EmiliamBeke/Mekatronikk-4-MEPA2002/src/robot_gz/models/sim_teddy_bear/materials/textures/back.png

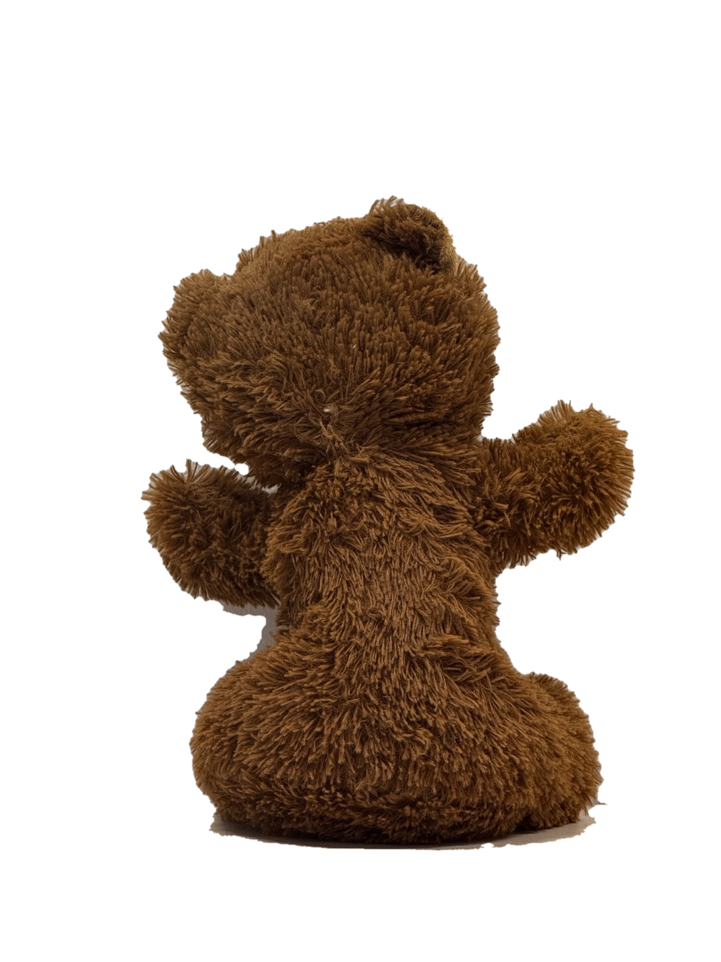
src/robot_gz/models/sim_teddy_bear/materials/textures/back.png
