EmiliamBeke/Mekatronikk-4-MEPA2002/docs/lidar_rviz.md

# LiDAR + YOLO Image i RViz (Pi + PC)

Kort oppskrift for å se LiDAR live i RViz.

Kamera- og YOLO-innstillinger ligger i [config/camera_params.yaml](/home/emiliam/Mekatronikk-4-MEPA2002/config/camera_params.yaml).
`camera_stream` gjelder felles stream til baade teddy-detektor og RViz, mens `teddy_detector` bare gjelder YOLO-parametre.
Hvis fargene ser feil ut, er `camera_stream.awb`, `awb_gains`, `brightness`, `contrast`, `saturation`, `sharpness`, `denoise` og `ev` de foerste feltene aa justere.

## 1) Start robotstack på Pi

```bash
cd ~/Mekatronikk-4-MEPA2002
WITH_NAV2=0 WITH_TEDDY=1 make pi-bringup
```

Dette scriptet:

1. finner PC-IP fra SSH-sesjonen
2. setter `ROS_DOMAIN_ID`, `ROS_AUTOMATIC_DISCOVERY_RANGE` og `ROS_STATIC_PEERS`
3. starter `robot_state_publisher`, LiDAR og teddy-detektor i samme Docker-kjoering
4. sender annotert YOLO-video til PC hvis `teddy_detector.stream_debug_video: true` i [config/camera_params.yaml](/home/emiliam/Mekatronikk-4-MEPA2002/config/camera_params.yaml)

Hvis du bare vil se LiDAR + TF uten teddy:

```bash
WITH_NAV2=0 make pi-bringup
```

## 2) Start RViz-oppsettet på PC

Fra PC-en er standarden naa:

```bash
cd ~/Mekatronikk-4-MEPA2002
make pc-teddy-rviz
```

Dette scriptet:

1. setter ROS discovery mot Pi automatisk
2. starter lokal UDP->ROS bridge for annotert YOLO-bilde
3. aapner RViz med [rviz.rviz](/home/emiliam/Mekatronikk-4-MEPA2002/src/robot_bringup/rviz/rviz.rviz)

Hvis hostnavnet ikke virker, bruk Pi-IP direkte:

```bash
make pc-teddy-rviz PI_HOST=192.168.10.55
```

## 3) Verifiser fra PC

```bash
ros2 topic list | grep lidar
ros2 topic hz /lidar
ros2 topic echo --once /tf_static
ros2 topic list | grep teddy_detector
```

## 4) Start RViz på PC

Denne konfigen er laget for situasjonen deres akkurat naa:

1. `Fixed Frame = odom`
2. `LaserScan` bruker `/lidar` med `Reliability = Best Effort`
3. `RobotModel` bruker `/robot_description`
4. `Image`-display viser `/camera`
5. `TF`, odometri, footprint og planer kan slas av/paa i samme konfig

Hvis du vil sette opp manuelt i stedet:

1. `Global Options -> Fixed Frame = odom`
2. `Add -> LaserScan`
3. `Topic = /lidar`
4. Under `Topic`:
   `Reliability Policy = Best Effort`
5. `Add -> RobotModel` og bruk `/robot_description`
6. `Add -> Image` og bruk `/camera`
7. Bruk `odom` som fixed frame naar odometri er oppe

## 5) Valgfritt: raa kamera til RViz over UDP

Pi:

```bash
WITH_NAV2=0 WITH_TEDDY=1 WITH_CAMERA_RVIZ=1 make pi-bringup
```

Dette beholder teddy-detektor paa Pi, men sender i tillegg H264 over UDP til PC-en paa port `5601`.

PC:

```bash
make pc-camera-rviz PI_HOST=gruppe5pi5
```

Det starter en lokal ROS-node paa PC-en som dekoder UDP-stroemmen og publiserer `/camera`.
Dette er valgfritt; standarden deres naa er annotert YOLO-bilde via `make pc-teddy-rviz`.

## Feilsøking (kort)

- `empty topicname`: `LaserScan`-display har tom `Topic`. Sett `/lidar`.
- Ingen topic på PC: sjekk at `make pi-bringup` fortsatt kjører på Pi, og prøv `make pc-teddy-rviz PI_HOST=<pi-host-eller-ip>` på nytt.
- Hvis `RobotModel` ser rar ut, men `tf2_echo chassis base_laser` ser riktig ut: stol heller på LiDAR + TF foreløpig. Dere publiserer ikke `/joint_states` ennå.
- Hvis YOLO-bilde ikke vises på PC: sjekk at PC-workspace er bygget, at `make pc-teddy-rviz` fortsatt kjører, og at UDP-port `5602` ikke blokkeres.
- Hvis råkamera ikke vises på PC: sjekk at `gst-launch-1.0` finnes på PC, og at UDP-port `5601` ikke blokkeres.
- Hvis `/dev/ttyAMA0` ikke virker: test `port_name:=/dev/serial0`.
- Hvis auto-detection på Pi bommer: bruk `PC_HOST=<pc-ip> make pi-bringup`.
