EmiliamBeke/Mekatronikk-4-MEPA2002/src/robot_description/meshes/RFWheelColision.stl

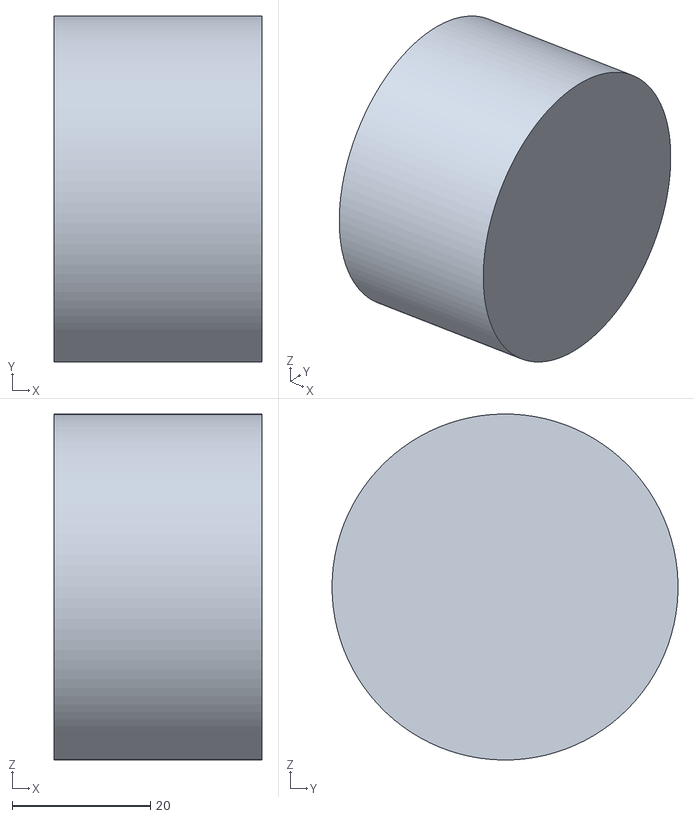
[picture p5: CAD file, 2026-05-09]
src/robot_description/meshes/RFWheelColision.stl
30.0 x 50.0 x 50.0
