EmiliamBeke/Mekatronikk-4-MEPA2002/src/robot_gz/models/tracked_robot/meshes/BLLegs.stl

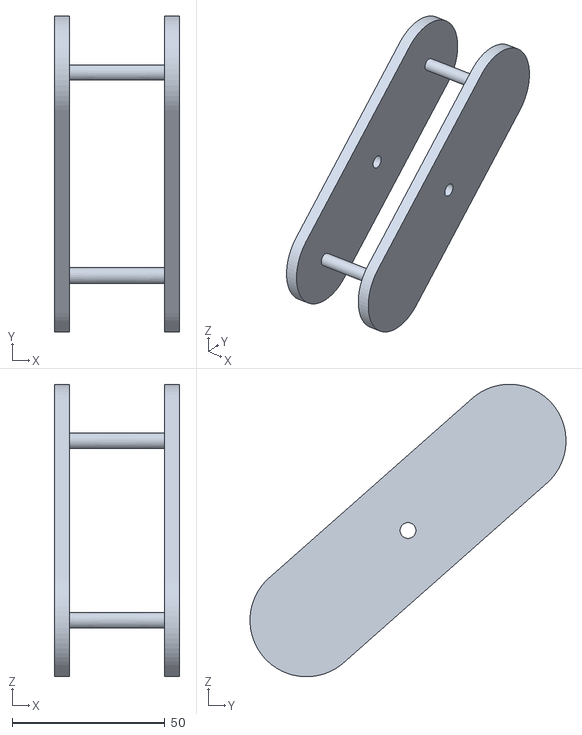
[picture p6: CAD file, 2026-05-09]
src/robot_gz/models/tracked_robot/meshes/BLLegs.stl
41.0 x 103.5 x 95.7
