EmiliamBeke/Mekatronikk-4-MEPA2002/src/robot_description/meshes/LDriveWheel.stl

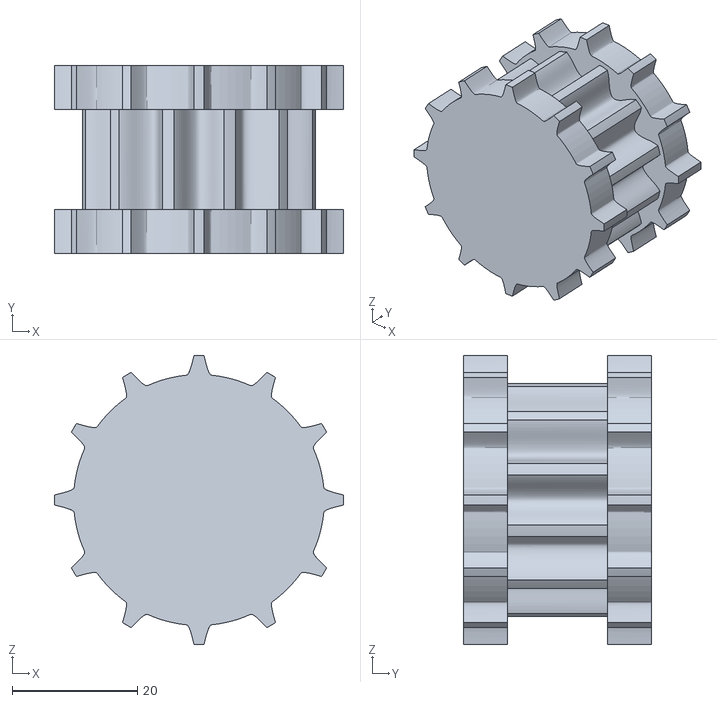
[picture p7: CAD file, 2026-05-09]
src/robot_description/meshes/LDriveWheel.stl
46.1 x 30.0 x 46.1
