EmiliamBeke/Mekatronikk-4-MEPA2002/src/robot_gz/models/tracked_robot/meshes/Xstepper.stl

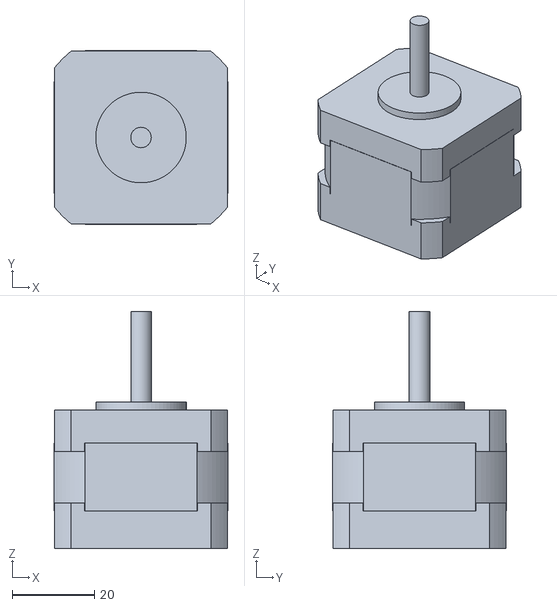
[picture p8: CAD file, 2026-05-09]
src/robot_gz/models/tracked_robot/meshes/Xstepper.stl
42.2 x 42.2 x 57.6
