EmiliamBeke/Mekatronikk-4-MEPA2002/src/robot_description/meshes/rps-kamera-v2-2.stl

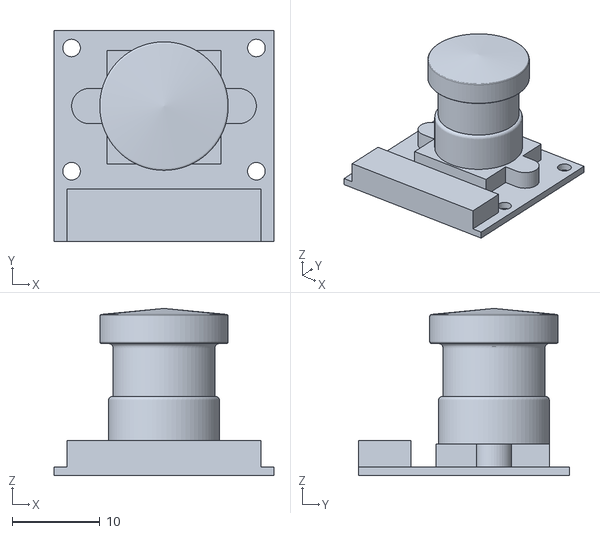
[picture p9: CAD file, 2026-05-09]
src/robot_description/meshes/rps-kamera-v2-2.stl
25.0 x 24.0 x 19.0
