EmiliamBeke/Mekatronikk-4-MEPA2002/src/robot_gz/models/tracked_robot/meshes/Gripper.stl

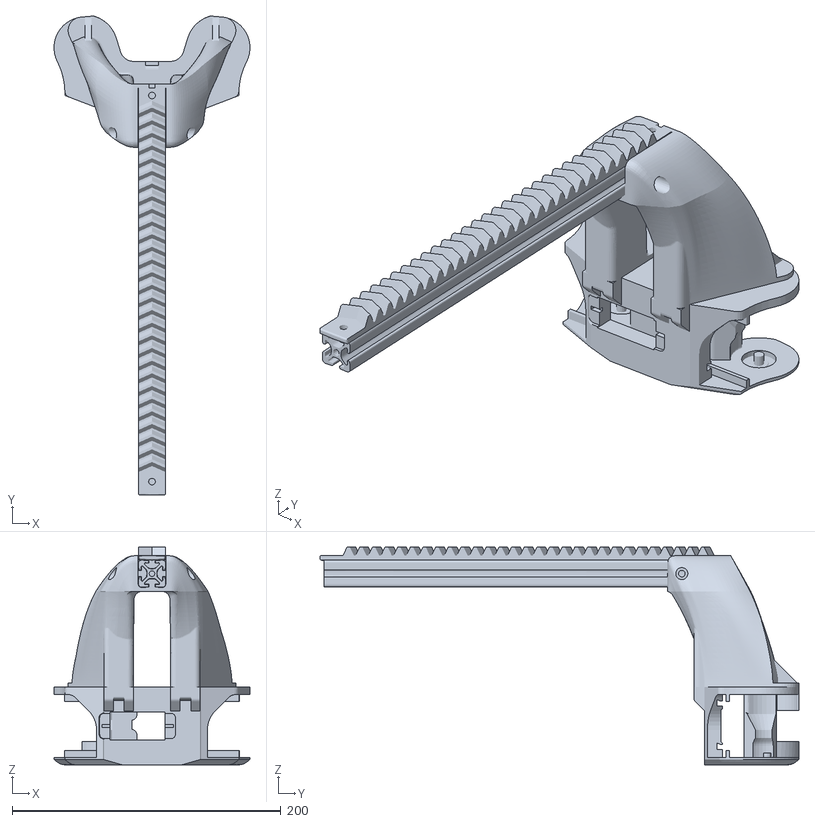
[picture p10: CAD file, 2026-05-09]
src/robot_gz/models/tracked_robot/meshes/Gripper.stl
146.0 x 356.8 x 162.3
