EmiliamBeke/Mekatronikk-4-MEPA2002/src/robot_description/meshes/Mega-wsheeld-v5-1.stl

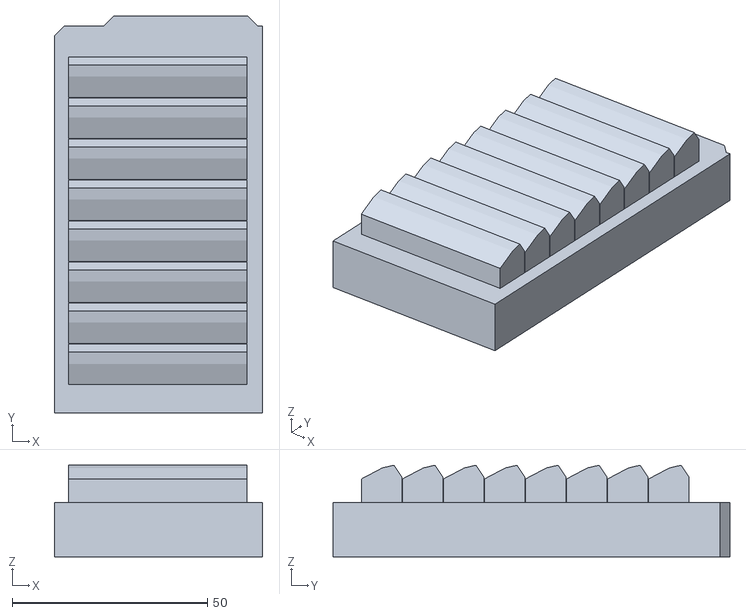
[picture p11: CAD file, 2026-05-09]
src/robot_description/meshes/Mega-wsheeld-v5-1.stl
53.3 x 101.6 x 23.4
