EmiliamBeke/Mekatronikk-4-MEPA2002/src/robot_gz/models/tracked_robot/meshes/StøtteStag-1.stl

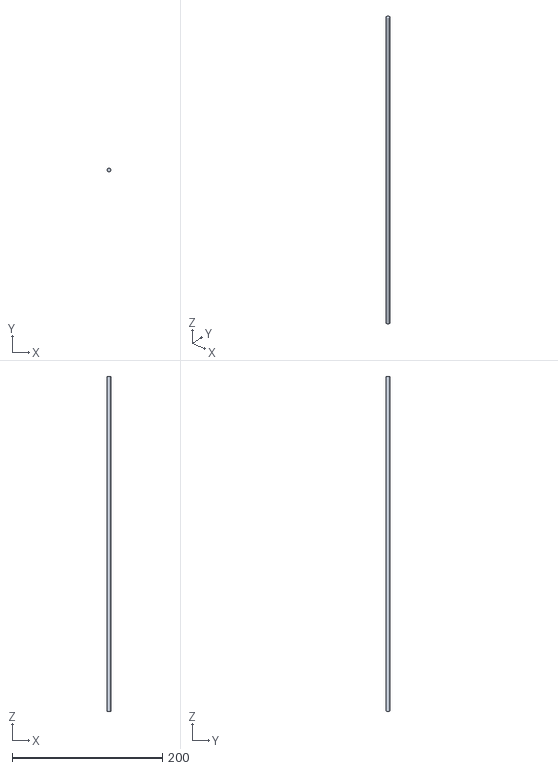
[picture p12: CAD file, 2026-05-09]
src/robot_gz/models/tracked_robot/meshes/StøtteStag-1.stl
5.00 x 4.87 x 445.3
