EmiliamBeke/Mekatronikk-4-MEPA2002/src/robot_description/meshes/M1.stl

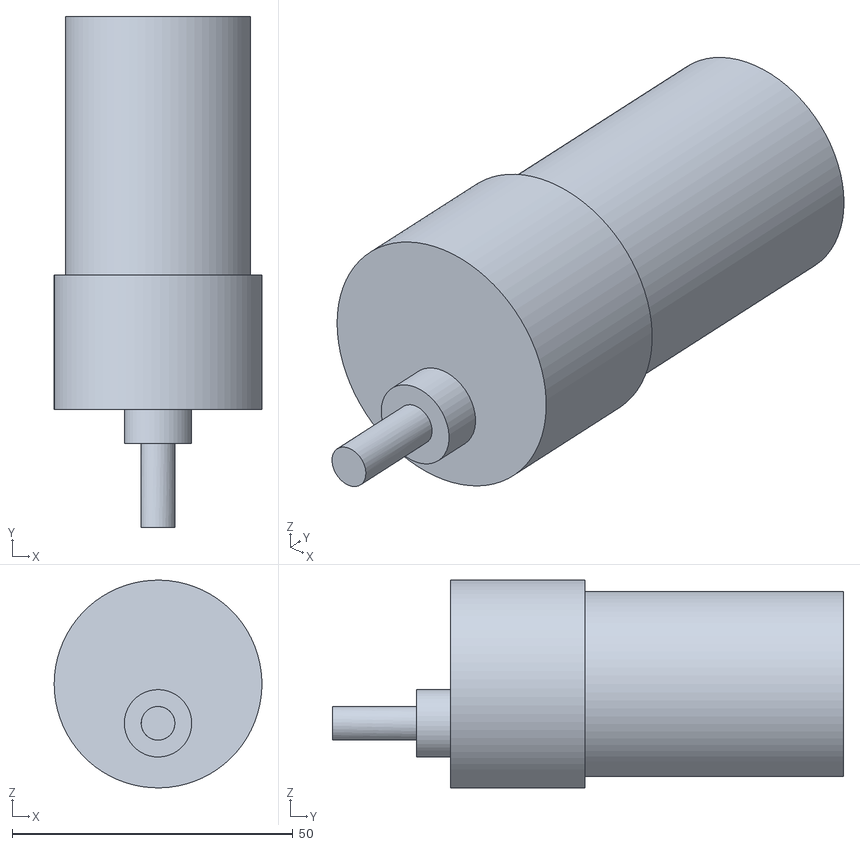
[picture p13: CAD file, 2026-05-09]
src/robot_description/meshes/M1.stl
37.0 x 91.0 x 37.0
