EmiliamBeke/Mekatronikk-4-MEPA2002/src/robot_gz/models/tracked_robot/meshes/Servo-Gear-8L30.00-m2.1651.stl

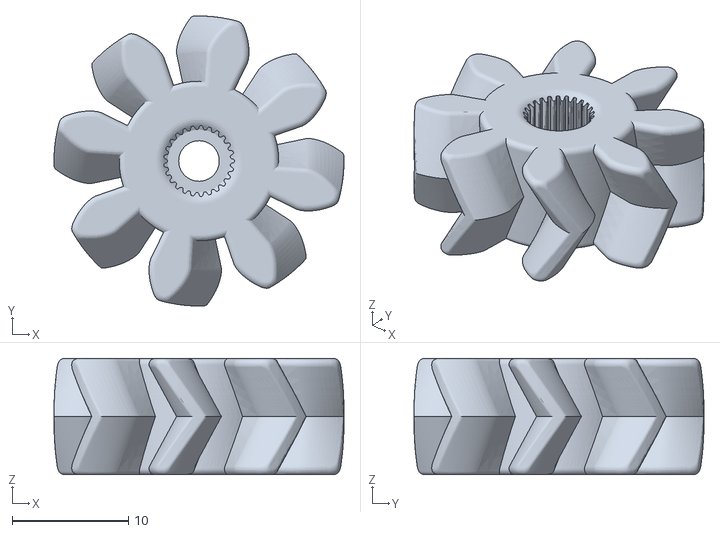
[picture p14: CAD file, 2026-05-09]
src/robot_gz/models/tracked_robot/meshes/Servo-Gear-8L30.00-m2.1651.stl
25.0 x 25.0 x 10.0
