EmiliamBeke/Mekatronikk-4-MEPA2002/src/robot_gz/models/tracked_robot/meshes/LTracks.stl

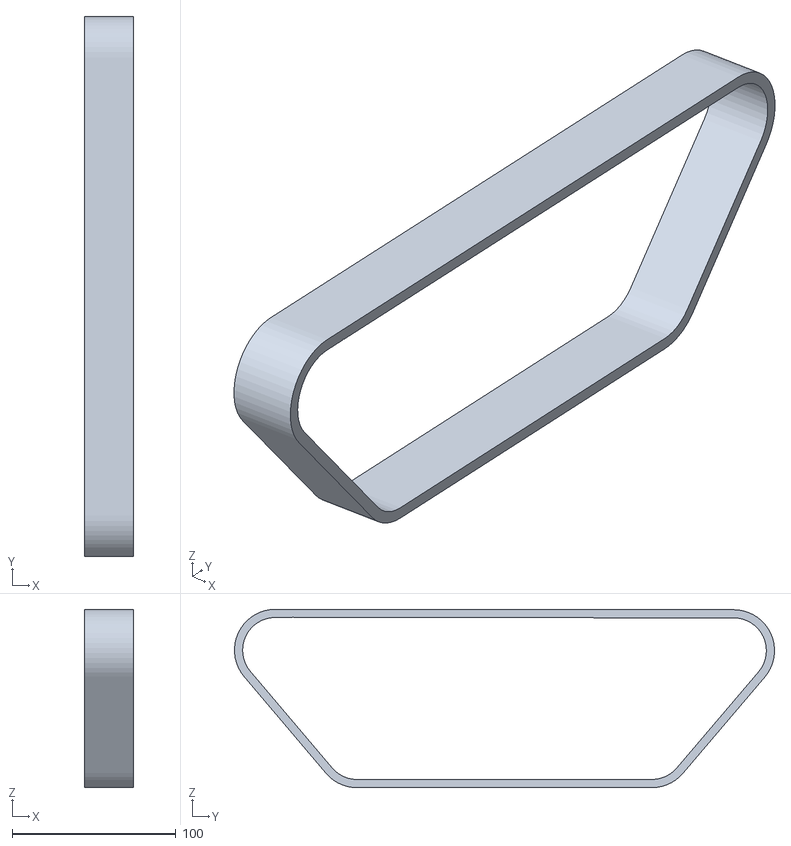
[picture p15: CAD file, 2026-05-09]
src/robot_gz/models/tracked_robot/meshes/LTracks.stl
30.0 x 329.9 x 109.0
