EmiliamBeke/Mekatronikk-4-MEPA2002/src/robot_description/meshes/LFWheel.stl

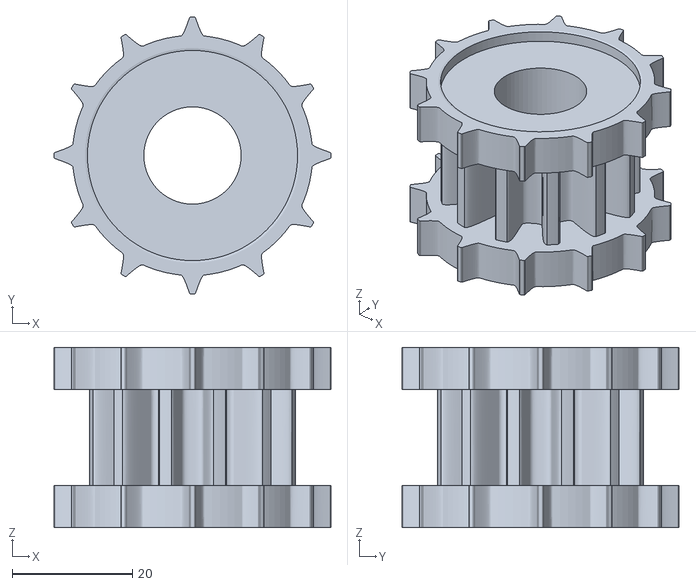
[picture p16: CAD file, 2026-05-09]
src/robot_description/meshes/LFWheel.stl
46.1 x 46.1 x 30.0
