EmiliamBeke/Mekatronikk-4-MEPA2002/src/robot_gz/models/tracked_robot/meshes/LD06_LiDAR-1.stl

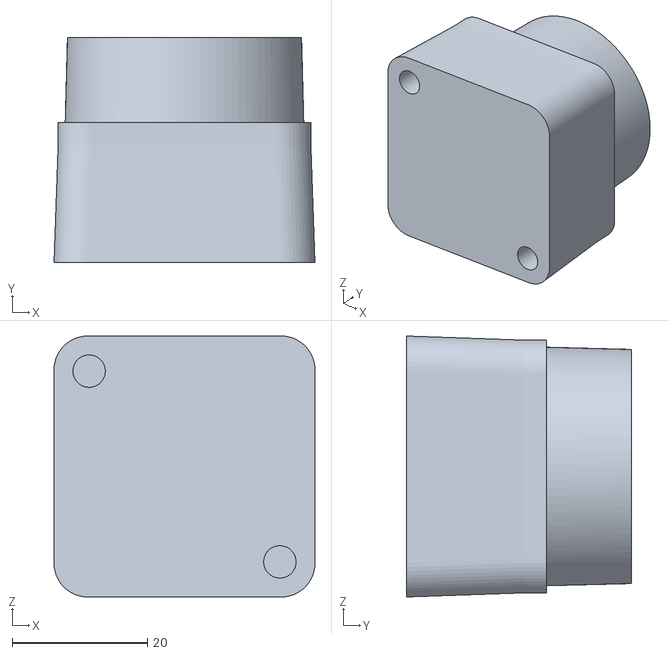
[picture p17: CAD file, 2026-05-09]
src/robot_gz/models/tracked_robot/meshes/LD06_LiDAR-1.stl
38.6 x 33.3 x 38.6
