EmiliamBeke/Mekatronikk-4-MEPA2002/src/robot_description/meshes/LeadNutL.stl

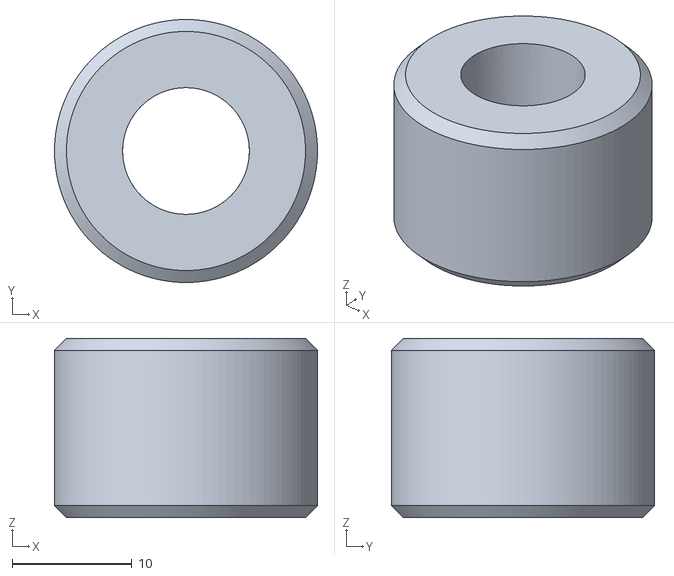
[picture p18: CAD file, 2026-05-09]
src/robot_description/meshes/LeadNutL.stl
22.0 x 22.0 x 15.0
