EmiliamBeke/Mekatronikk-4-MEPA2002/src/robot_gz/models/tracked_robot/meshes/Unyaktig-batteri-mockup-v1-1.stl

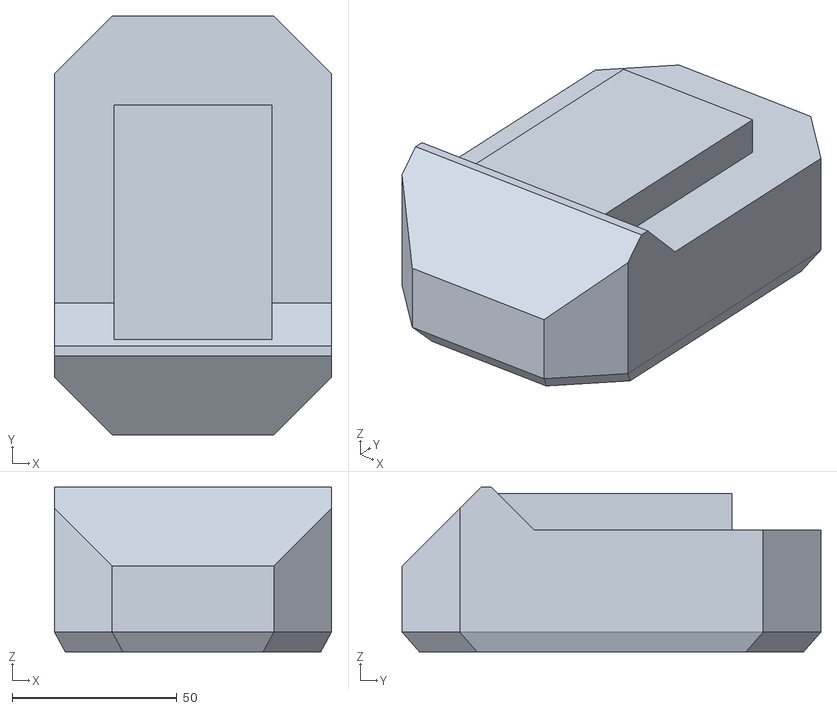
[picture p19: CAD file, 2026-05-09]
src/robot_gz/models/tracked_robot/meshes/Unyaktig-batteri-mockup-v1-1.stl
84.0 x 127.0 x 50.0
