EmiliamBeke/Mekatronikk-4-MEPA2002/src/robot_description/meshes/Chassis.stl

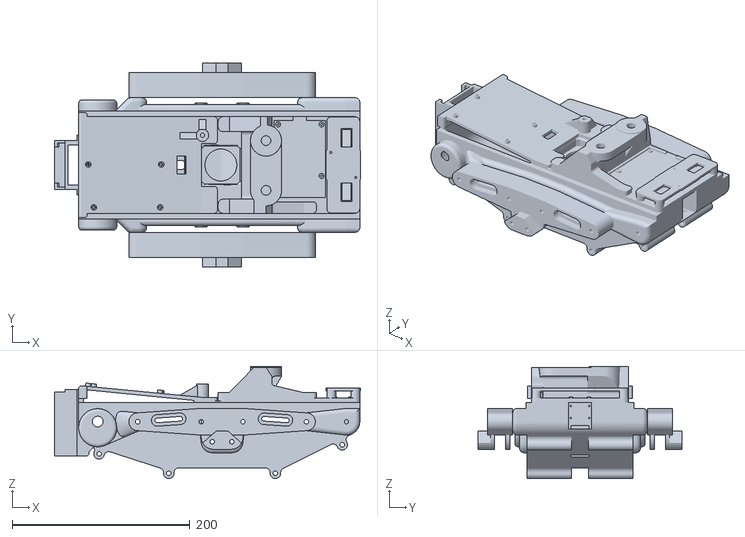
[picture p20: CAD file, 2026-05-09]
src/robot_description/meshes/Chassis.stl
344.4 x 229.6 x 126.2
