EmiliamBeke/Mekatronikk-4-MEPA2002/src/robot_description/meshes/Finger-R16L30.00-m2.1651Mirror.stl

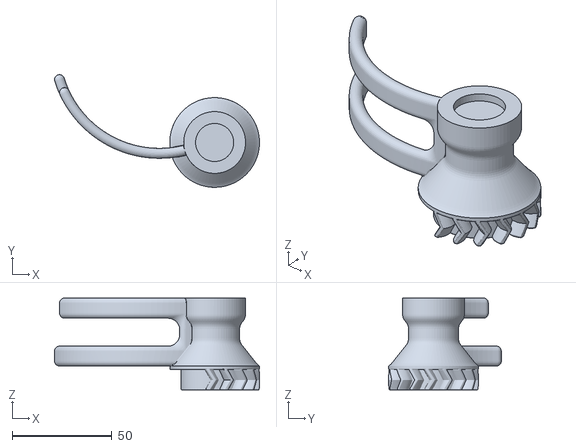
[picture p21: CAD file, 2026-05-09]
src/robot_description/meshes/Finger-R16L30.00-m2.1651Mirror.stl
102.8 x 56.5 x 46.1
