EmiliamBeke/Mekatronikk-4-MEPA2002/src/robot_description/meshes/Gear-9R24.00-m2.741-1-1.stl

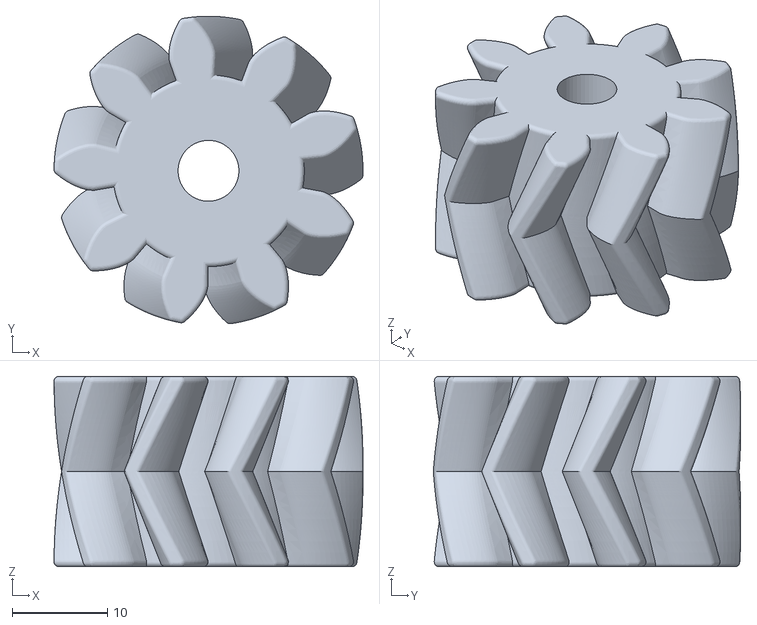
[picture p22: CAD file, 2026-05-09]
src/robot_description/meshes/Gear-9R24.00-m2.741-1-1.stl
32.5 x 32.3 x 20.0
