EmiliamBeke/Mekatronikk-4-MEPA2002/src/robot_gz/models/tracked_robot/meshes/BN0085.stl

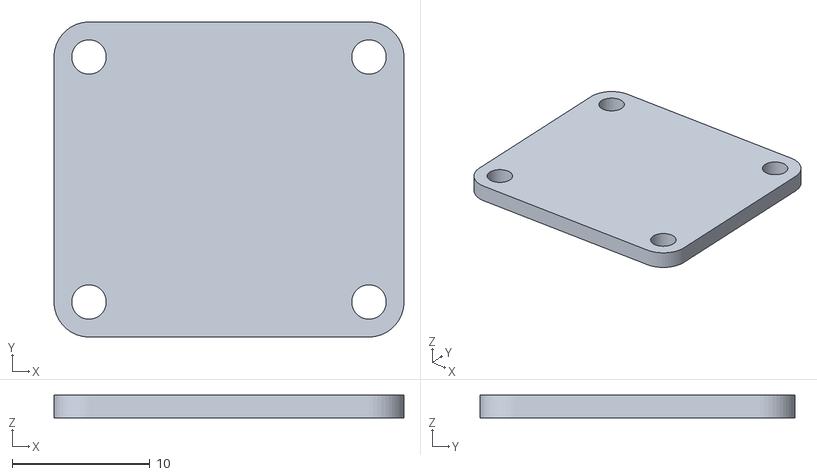
[picture p23: CAD file, 2026-05-09]
src/robot_gz/models/tracked_robot/meshes/BN0085.stl
25.4 x 22.9 x 1.65
