EmiliamBeke/Mekatronikk-4-MEPA2002/src/robot_description/meshes/Top-Rack-200.0mm-R30.00-m2.1651.stl

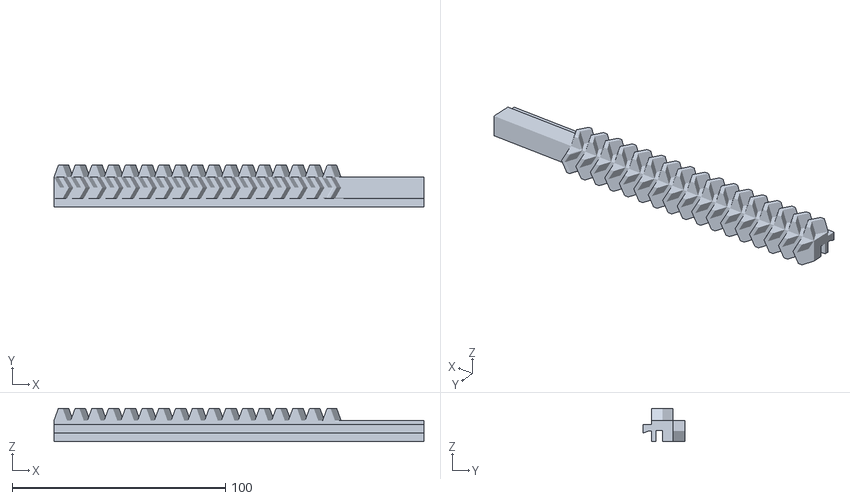
[picture p24: CAD file, 2026-05-09]
src/robot_description/meshes/Top-Rack-200.0mm-R30.00-m2.1651.stl
173.5 x 19.6 x 15.6
