EmiliamBeke/Mekatronikk-4-MEPA2002/src/robot_gz/models/tracked_robot/meshes/PI5.stl

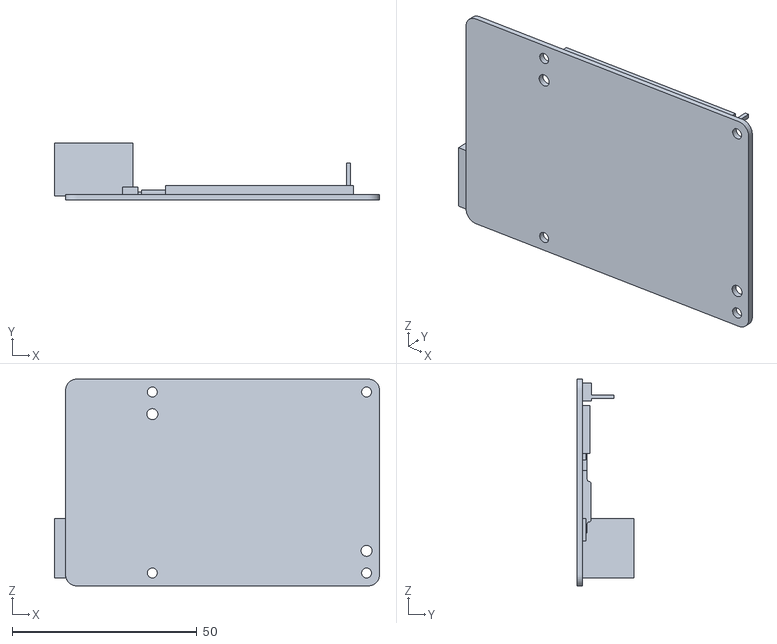
[picture p25: CAD file, 2026-05-09]
src/robot_gz/models/tracked_robot/meshes/PI5.stl
88.0 x 15.3 x 56.0
