EmiliamBeke/Mekatronikk-4-MEPA2002/src/robot_description/meshes/Servo.stl

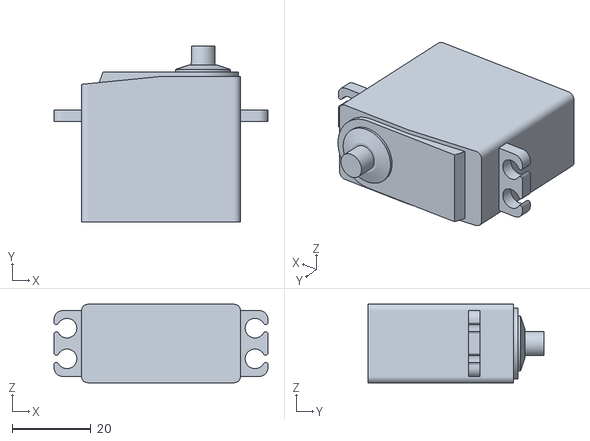
[picture p26: CAD file, 2026-05-09]
src/robot_description/meshes/Servo.stl
54.5 x 44.7 x 20.0
