EmiliamBeke/Mekatronikk-4-MEPA2002/src/robot_description/meshes/ZStepper.stl

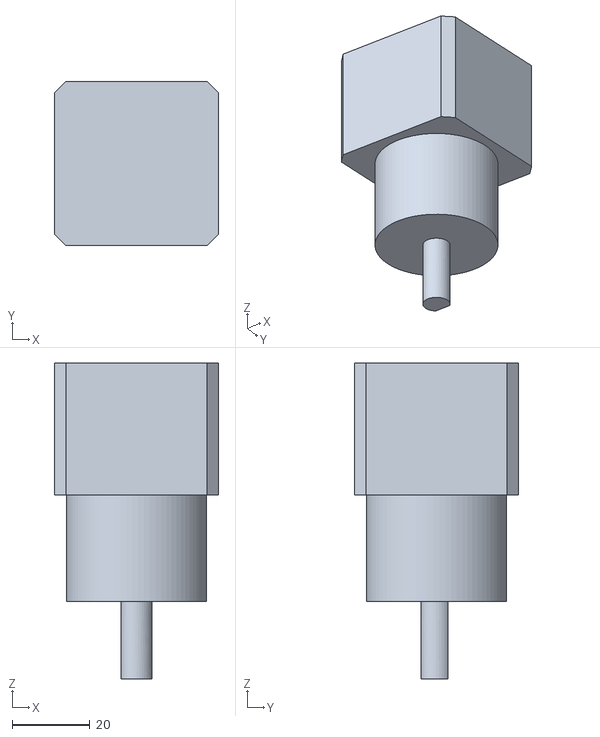
[picture p28: CAD file, 2026-05-09]
src/robot_description/meshes/ZStepper.stl
42.3 x 42.3 x 81.3
