EmiliamBeke/Mekatronikk-4-MEPA2002/(list of files, cad)

Other CAD files:
src/robot_gz/models/tracked_robot/meshes/FRLegs.stl
src/robot_gz/models/tracked_robot/meshes/FLLegs.stl
src/robot_gz/models/tracked_robot/meshes/RTracks.stl
src/robot_description/meshes/RTWheel.stl
src/robot_gz/models/tracked_robot/meshes/RTWheel.stl
src/robot_description/meshes/BRLegs.stl
src/robot_description/meshes/RDriveWheel.stl
src/robot_gz/models/tracked_robot/meshes/RFWheel.stl
src/robot_description/meshes/RBWheel.stl
src/robot_description/meshes/Finger-L-16L30.00-m2.1651.stl
src/robot_gz/models/tracked_robot/meshes/RBWheel.stl
src/robot_gz/models/tracked_robot/meshes/Finger-L-16L30.00-m2.1651.stl
src/robot_description/meshes/FRLegs.stl
src/robot_description/meshes/FLLegs.stl
src/robot_description/meshes/RFWheel.stl
src/robot_gz/models/tracked_robot/meshes/Bottom-Rack-200.0mm-L30.00-m2.1651.stl
src/robot_gz/models/tracked_robot/meshes/M2.stl
src/robot_gz/models/tracked_robot/meshes/RDriveWheel.stl
src/robot_description/meshes/M2.stl
src/robot_gz/models/tracked_robot/meshes/BRLegs.stl
src/robot_description/meshes/RTracks.stl
src/robot_description/meshes/Bottom-Rack-200.0mm-L30.00-m2.1651.stl
src/robot_description/meshes/ABX00102-Dist-sensor.stl
src/robot_description/meshes/LLeadscrew.stl
src/robot_description/meshes/Leadscrew-Rigg.stl
src/robot_description/meshes/RLeadscrew.stl
src/robot_gz/models/tracked_robot/meshes/ABX00102-Dist-sensor.stl
src/robot_gz/models/tracked_robot/meshes/LLeadscrew.stl
src/robot_gz/models/tracked_robot/meshes/Leadscrew-Rigg.stl
src/robot_gz/models/tracked_robot/meshes/RLeadscrew.stl
