EmiliamBeke/Mekatronikk-4-MEPA2002/docs/wiki/build-and-environment.md

# Bygg og Miljø

## Bunnlinje

PC/sim bygges normalt direkte med colcon. Pi/runtime bygges normalt inne i Docker.
Source order betyr noe utenfor Docker.

## Host / PC Build

```bash
cd ~/Mekatronikk-4-MEPA2002
source /opt/ros/jazzy/setup.bash
colcon build --symlink-install
source install/setup.bash
```

Bruk dette for:

- Gazebo simulering.
- RViz.
- PC UDP camera bridge.
- PC ROS keyboard teleop.

## Pi / Docker Build

```bash
cd ~/Mekatronikk-4-MEPA2002
make ws
```

Dette er normal Pi-build for kodeendringer. `make ws` bygger ROS-workspacet i
det Docker-imaget som allerede finnes.

`make build` er **ikke** en vanlig operatørkommando. Ikke bygg Docker-imaget på
nytt bare fordi du har endret Python-kode, launch-filer, YAML-konfig eller
Arduino-sketcher.

Buildx / BuildKit (anbefalt for Pi)
----------------------------------

Pi-en bruker nå `docker buildx` og BuildKit for mer pålitelige builds med
`docker/` som build-context. Buildx-builderen beholder intern layer-cache mellom
builds, men Makefile eksporterer ikke lenger ekstra lokal cache til
`~/.buildx-cache`.

Bruk disse Makefile-målene for å sette opp og bygge med Buildx:

```bash
# opprett og bootstrap en lokal buildx-builder (kjør én gang)
make docker-buildx-setup

# bygg med Buildx og last image inn i Docker
make docker-buildx-build

# fjern builder/cache hvis du vil starte helt på nytt
make docker-buildx-clean
```

`docker/Dockerfile` bruker ikke apt/pip cache-mounts. Pi-en har raskt nettverk,
men tregt SD-kort, så default build prioriterer lavere disk-I/O og mindre
cache-vekst over å cache nedlastede pakker. Buildx layer-cache beholdes.

`make build` er en kort alias for `make docker-buildx-build`.

Hvis gammel lokal Buildx-cache fra tidligere oppsett finnes i `~/.buildx-cache`,
rydd den med:

```bash
make docker-buildx-clean
```

| Kommando | Effekt |
|---|---|
| `make build` | Bygger Docker-imaget på nytt ved å bruke Buildx (`make docker-buildx-build`). Bruk sjelden. |
| `make ws` | Kjører [`scripts/ws_build.sh`](../../scripts/ws_build.sh) i container |
| `make shell` | Åpner shell i container |
| `make up` | Starter compose service detached |
| `make down` | Stopper compose service |

Kjør `make build` bare etter endringer i:

- [`docker/Dockerfile`](../../docker/Dockerfile)
- apt-pakker i Dockerfile.
- pip-pakker i Dockerfile.
- base image eller Docker runtime-oppsett.
- systembiblioteker som må finnes inne i containeren.

Eksempler som **ikke** krever `make build`:

- endringer i `src/**/*.py`
- endringer i launch-filer
- endringer i `config/*.yaml`
- endringer i `README.md` eller `docs/`
- endringer i Arduino-sketcher

For de fleste repoendringer er dette riktig:

```bash
make ws
```

Kjør `make ws` etter endringer i:

- ROS Python/C++ kode.
- Launch-filer.
- Package metadata.
- Config som installeres av `robot_bringup`.

`make pi-bringup` sjekker også om installasjonen mangler eller er stale for
noen sentrale launch/node-filer, og kjører `make ws` automatisk ved behov.

## Docker Image

[`docker/Dockerfile`](../../docker/Dockerfile) bruker:

- Base image: `ros:jazzy-ros-base`
- ROS packages:
  - `ros-jazzy-navigation2`
  - `ros-jazzy-cv-bridge`
  - `ros-jazzy-robot-localization`
  - `ros-dev-tools`
- Python venv i `/opt/venv`
- Python packages:
  - `numpy==1.26.4`
  - `pyserial==3.5`
  - `ultralytics==8.4.12`
  - `ncnn==1.0.20260114`
  - `lgpio`
  - `adafruit-blinka`
  - `adafruit-circuitpython-bno08x`
  - `adafruit-extended-bus`

## Workspace Build Script

[`scripts/ws_build.sh`](../../scripts/ws_build.sh):

1. Fjerner stale Python package state i `/ws/build/<pkg>` og `/ws/install/<pkg>`.
2. Kjører `colcon build --symlink-install`.
3. Patcher console script shebang fra `/usr/bin/python3` til `/opt/venv/bin/python3`.

Dette er nødvendig fordi containerens pip-pakker ligger i venv.

## Source Order Uten Docker

```bash
source /opt/ros/jazzy/setup.bash
source install/setup.bash
```

Hvis du får `package not found` eller gamle launch-filer:

```bash
source /opt/ros/jazzy/setup.bash
colcon build --symlink-install
source install/setup.bash
```

## ROS Nettverk

ROS discovery styres av [`scripts/ros_discovery_env.sh`](../../scripts/ros_discovery_env.sh).

Variabler:

| Variabel | Bruk |
|---|---|
| `ROS_DOMAIN_ID` | DDS domain, default `0` |
| `ROS_AUTOMATIC_DISCOVERY_RANGE` | Discovery scope |
| `ROS_STATIC_PEERS` | Peer-IP mellom Pi og PC |

Manuell sjekk:

```bash
eval "$(bash scripts/ros_discovery_env.sh pc gruppe5pi5)"
env | grep ROS_
```
