EmiliamBeke/Mekatronikk-4-MEPA2002/src/robot_description/urdf/tracked_robot.urdf

<?xml version='1.0'?>
<robot name="tracked_robot">
  <link name="base_link" />
  <link name="Chassis">
    <inertial>
      <origin xyz="0.08016056471355223 0.09137425589873138 0.04160371992676176" rpy="0.0 0.0 0.0" />
      <mass value="1.4907690350907317" />
      <inertia ixx="0.00601805889102517" iyy="0.011696228691038965" izz="0.015388922827137485" ixy="2.7577451823444063e-05" iyz="6.282850546029949e-06" ixz="-0.0002627279587458808" />
    </inertial>
    <visual name="Chassis_visual">
      <origin xyz="0.0 0.0 0.0" rpy="0.0 0.0 0.0" />
      <geometry>
        <mesh filename="package://robot_description/meshes/Chassis.stl" scale="0.001 0.001 0.001" />
      </geometry>
    </visual>
  </link>
  <link name="Mega-wsheeld-v5-1">
    <inertial>
      <origin xyz="0.02418645169962702 0.0395070930422259 -0.00411905463171534" rpy="0.0 1.3877787807814457e-17 -1.5407439555097887e-33" />
      <mass value="0.11143362473176022" />
      <inertia ixx="9.047827396914211e-05" iyy="2.9224349716257692e-05" izz="0.0001094102599503685" ixy="1.1926726529571194e-06" iyz="-7.481815984518112e-06" ixz="-1.8679875245636037e-06" />
    </inertial>
    <visual name="Mega-wsheeld-v5-1_visual">
      <origin xyz="0.03137191759236502 0.013716749643378474 -0.07938573051964896" rpy="-3.046067226547428 -0.09552542704236638 -9.670704939521283e-16" />
      <geometry>
        <mesh filename="package://robot_description/meshes/Mega-wsheeld-v5-1.stl" scale="0.001 0.001 0.001" />
      </geometry>
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
      <origin xyz="0.0004999999999998739 2.0571900449795067e-09 3.7940931818525315e-09" rpy="3.1415926535897927 -1.5707963267948957 0" />
      <geometry>
        <mesh filename="package://robot_description/meshes/RTWheel.stl" scale="0.001 0.001 0.001" />
      </geometry>
    </visual>
  </link>
  <link name="RTracks">
    <inertial>
      <origin xyz="0.015497001220170227 -2.1846574448984858e-05 -0.03808202683919858" rpy="0.0 -0.0 1.0078327530580147e-47" />
      <mass value="0.12017843301436808" />
      <inertia ixx="0.0015067502460037604" iyy="0.00025369476259429224" izz="0.0012710822512843872" ixy="-2.675703037241863e-11" iyz="-3.397867383094469e-07" ixz="-1.8558039522643504e-08" />
    </inertial>
    <visual name="RTracks_visual">
      <origin xyz="-0.07570670275216816 -0.018303296940042214 -0.08511507140488098" rpy="0.0009707120072640304 7.874654083292796e-05 -1.1124863196142852e-16" />
      <geometry>
        <mesh filename="package://robot_description/meshes/RTracks.stl" scale="0.001 0.001 0.001" />
      </geometry>
      <material name="RTracks_hidden_material">
        <color rgba="0 0 0 0" />
      </material>
    </visual>
    <collision name="RTracks_drive_proxy_collision">
      <origin xyz="0.0912 0.01835843 -0.0965" rpy="0 0 0" />
      <geometry>
        <box size="0.030 0.210 0.007" />
      </geometry>
    </collision>
    <visual name="RTracks_drive_proxy_visual">
      <origin xyz="0.0912 0.01835843 -0.0965" rpy="0 0 0" />
      <geometry>
        <box size="0.030 0.210 0.007" />
      </geometry>
      <material name="RTracks_proxy_material">
        <color rgba="0 0.8 0.25 0.75" />
      </material>
    </visual>
  </link>
  <link name="LTracks">
    <inertial>
      <origin xyz="-0.015502998683714067 -2.1846574449120305e-05 -0.03807958569643533" rpy="5.473822126268817e-48 -0.0 8.446604675068861e-48" />
      <mass value="0.12017843301436808" />
      <inertia ixx="0.0015067502460037606" iyy="0.0002536947625942929" izz="0.0012710822512843954" ixy="-2.675703007410278e-11" iyz="-3.3978673830822716e-07" ixz="-1.8558039522449362e-08" />
    </inertial>
    <visual name="LTracks_visual">
      <origin xyz="-0.10670670265605249 -0.01830329694004238 -0.08511263026211786" rpy="0.0009707120072640304 7.874654083273901e-05 1.121604795330732e-17" />
      <geometry>
        <mesh filename="package://robot_description/meshes/LTracks.stl" scale="0.001 0.001 0.001" />
      </geometry>
      <material name="LTracks_hidden_material">
        <color rgba="0 0 0 0" />
      </material>
    </visual>
    <collision name="LTracks_drive_proxy_collision">
      <origin xyz="0.0912 0.01835843 -0.0965" rpy="0 0 0" />
      <geometry>
        <box size="0.030 0.210 0.007" />
      </geometry>
    </collision>
    <visual name="LTracks_drive_proxy_visual">
      <origin xyz="0.0912 0.01835843 -0.0965" rpy="0 0 0" />
      <geometry>
        <box size="0.030 0.210 0.007" />
      </geometry>
      <material name="LTracks_proxy_material">
        <color rgba="0 0.25 1 0.75" />
      </material>
    </visual>
  </link>
  <link name="LeadNutL">
    <inertial>
      <origin xyz="3.65143471015017e-13 3.0786747018396455e-09 5.932736968361497e-10" rpy="-3.0814879110195774e-33 4.930380657631324e-32 -2.899415157508014e-47" />
      <mass value="0.03449007966719112" />
      <inertia ixx="1.9041634639065265e-06" iyy="1.9041634831149027e-06" izz="2.549938761840499e-06" ixy="1.3552527156068792e-20" iyz="5.654597688218619e-23" ixz="2.6946065840981603e-20" />
    </inertial>
    <visual name="LeadNutL_visual">
      <origin xyz="2.4860113967406507e-14 3.0786747462485663e-09 5.932736968361497e-10" rpy="3.141592653589793 -9.034272702235832e-17 -1.5707963267948974" />
      <geometry>
        <mesh filename="package://robot_description/meshes/LeadNutL.stl" scale="0.001 0.001 0.001" />
      </geometry>
    </visual>
  </link>
  <link name="RBWheelColision">
    <inertial>
      <origin xyz="-3.033514845984797e-09 1.2379253533367774e-09 -7.105427357601002e-17" rpy="-1.8767390147207368e-47 -0.0 0.0" />
      <mass value="0.4624031863395291" />
      <inertia ixx="0.00010693073948690995" iyy="0.00010693073948690301" izz="0.00014450099573109837" ixy="-7.560427017958604e-34" iyz="2.1986451153486987e-18" ixz="9.411917832625387e-20" />
    </inertial>
    <visual name="RBWheelColision_visual">
      <origin xyz="-0.011209100000000196 0.07165210999999978 0.09119999942779532" rpy="-4.418802341145651e-16 1.5707963267948957 0" />
      <geometry>
        <mesh filename="package://robot_description/meshes/RBWheelColision.stl" scale="0.001 0.001 0.001" />
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
  </joint>
  <joint name="Chassis_Rigid-21" type="fixed">
    <origin xyz="0.12944320620590702 0.11899999999999991 -0.001440317942810001" rpy="-3.1415926535897927 3.8064789415719715e-16 -1.5707963267948974" />
    <parent link="Chassis" />
    <child link="LLeadscrew" />
  </joint>
  <joint name="robotarm_z_joint" type="prismatic">
    <origin xyz="0.0 0.0 -0.500259" rpy="-3.141592653589793 9.860761315262648e-32 -8.292084300511961e-32" />
    <parent link="RLeadscrew" />
    <child link="Leadscrew-Rigg" />
    <axis xyz="4.930380657631324e-32 4.930380657631324e-32 1.0" />
    <limit lower="0.0" upper="0.25" effort="1000000" velocity="1000000" />
  </joint>
  <joint name="Leadscrew-Rigg_Rigid-23" type="fixed">
    <origin xyz="0.0 0.0 -0.3525" rpy="3.141592653589793 9.860761315262648e-32 -3.6134346367594863e-31" />
    <parent link="Leadscrew-Rigg" />
    <child link="LeadNutR" />
  </joint>
  <joint name="Leadscrew-Rigg_Rigid-25" type="fixed">
    <origin xyz="-0.043 -0.046 -0.32900000000000007" rpy="1.5707963267948966 9.860761315262648e-32 -9.736333669843527e-32" />
    <parent link="Leadscrew-Rigg" />
    <child link="Xstepper" />
  </joint>
  <joint name="Leadscrew-Rigg_Revolute-26" type="fixed">
    <origin xyz="-0.028000000000000004 -0.046 -0.32900000000000007" rpy="1.5707963267948966 2.4651903288156628e-31 -1.6412823737069552e-31" />
    <parent link="Leadscrew-Rigg" />
    <child link="Stepper-Gear-9R24.00-m2.741-1" />
  </joint>
  <joint name="Chassis_Rigid-27" type="fixed">
    <origin xyz="0.05794320620590703 0.12499999999999994 0.056559682057189975" rpy="-3.1415926535897927 3.8064789415719715e-16 -1.5707963267948974" />
    <parent link="Chassis" />
    <child link="StøtteStag-1" />
  </joint>
  <joint name="Leadscrew-Rigg_Revolute-28" type="fixed">
    <origin xyz="-0.028000000000000004 0.024000000000000004 -0.32900000000000007" rpy="1.5707963267948966 2.4651903288156628e-31 -1.6412823737069552e-31" />
    <parent link="Leadscrew-Rigg" />
    <child link="Gear-9R24.00-m2.741-1-1" />
  </joint>
  <joint name="robotarm_x_joint" type="prismatic">
    <origin xyz="-0.028000000000000004 -0.011000000000000006 -0.319" rpy="-9.860761315262648e-32 9.860761315262648e-32 -9.736333669843527e-32" />
    <parent link="Leadscrew-Rigg" />
    <child link="Gripper" />
    <axis xyz="-6.676490067226021e-32 1.0 0.0" />
    <limit lower="-0.07" upper="0.082" effort="1000000" velocity="1000000" />
  </joint>
  <joint name="Gripper_Rigid-30" type="fixed">
    <origin xyz="-0.01075 0.15057500000000001 -0.15480967999999998" rpy="3.141592653589793 -1.5707963267948966 0" />
    <parent link="Gripper" />
    <child link="Servo" />
  </joint>
  <joint name="Gripper_Rigid-31" type="fixed">
    <origin xyz="0.0 0.185 -0.15391655999999998" rpy="-3.141592653589793 1.5707963267948966 0" />
    <parent link="Gripper" />
    <child link="ABX00102-Dist-sensor" />
  </joint>
  <joint name="Servo_Revolute-32" type="fixed">
    <origin xyz="-8.881784197001253e-18 -0.01620000000000001 0.010749999999999989" rpy="1.5707963267948966 -1.5707963267948966 0" />
    <parent link="Servo" />
    <child link="Servo-Gear-8L30.00-m2.1651" />
  </joint>
  <joint name="Gripper_Slider-33" type="fixed">
    <origin xyz="-0.06508702 0.16570113000000003 -0.13650968" rpy="-3.141592653589793 -4.930380657631324e-32 -1.7755910601422187e-32" />
    <parent link="Gripper" />
    <child link="Top-Rack-200.0mm-R30.00-m2.1651" />
  </joint>
  <joint name="Gripper_Slider-34" type="fixed">
    <origin xyz="0.06492049 0.16570124 -0.17300967999999997" rpy="9.860761315262648e-32 -4.930380657631324e-32 -1.7755910601422187e-32" />
    <parent link="Gripper" />
    <child link="Bottom-Rack-200.0mm-L30.00-m2.1651" />
  </joint>
  <joint name="right_gripper_finger_joint" type="revolute">
    <origin xyz="0.05 0.19514971000000003 -0.15470968" rpy="-3.141592653589793 -5.473822126268811e-47 -2.0088433502773093e-31" />
    <parent link="Gripper" />
    <child link="Finger-R16L30.00-m2.1651Mirror" />
    <axis xyz="4.930380657631324e-32 4.930380657631326e-32 1.0000000000000007" />
    <limit lower="0.0" upper="8.0" effort="1000000" velocity="1000000" />
  </joint>
  <joint name="left_gripper_finger_joint" type="revolute">
    <origin xyz="-0.05 0.19514971000000003 -0.15470968" rpy="-3.141592653589793 -5.473822126268811e-47 -2.0088433502773093e-31" />
    <parent link="Gripper" />
    <child link="Finger-L-16L30.00-m2.1651" />
    <axis xyz="4.930380657631324e-32 4.930380657631326e-32 1.0000000000000007" />
    <limit lower="0.0" upper="8.0" effort="1000000" velocity="1000000" />
  </joint>
  <joint name="Chassis_Rigid-37" type="fixed">
    <origin xyz="-0.0600000037940929 0.16270000000000004 0.045250002057189945" rpy="1.570796326794897 3.8064789415719715e-16 -1.5707963267948974" />
    <parent link="Chassis" />
    <child link="M1" />
  </joint>
  <joint name="Chassis_Rigid-38" type="fixed">
    <origin xyz="-0.060000003794093 0.020300000000000092 0.04525000205718989" rpy="-1.5707963267948961 3.8064789415719715e-16 -1.5707963267948974" />
    <parent link="Chassis" />
    <child link="M2" />
  </joint>
  <joint name="Leadscrew-Rigg_Rigid-39" type="fixed">
    <origin xyz="-0.055999999999999994 0.0 -0.3525" rpy="-3.141592653589793 -2.9605947323337477e-16 -3.6891410794762184e-31" />
    <parent link="Leadscrew-Rigg" />
    <child link="LeadNutL" />
  </joint>
  <joint name="Chassis_Rigid-40" type="fixed">
    <origin xyz="0.07999578620590705 0.16719999999999993 0.059998152057189995" rpy="3.806478953373988e-16 -7.874654083273897e-05 -1.5707963267948974" />
    <parent link="Chassis" />
    <child link="LTracks" />
  </joint>
  <joint name="Chassis_Rigid-41" type="fixed">
    <origin xyz="0.07999578620590693 0.015799999999999967 0.05999815205718994" rpy="3.806478953373988e-16 -7.874654083292792e-05 -1.5707963267948974" />
    <parent link="Chassis" />
    <child link="RTracks" />
  </joint>
  <joint name="FLLegs_Revolute-42" type="continuous">
    <origin xyz="-0.01549999999999999 -0.05873733 -0.06652989999999999" rpy="-1.5707963267948957 -3.8761492285297827e-31 1.570796326794897" />
    <parent link="FLLegs" />
    <child link="RFWheelColision-1" />
    <axis xyz="3.8064789415719626e-16 8.049125398861859e-16 1.0" />
  </joint>
  <joint name="BLLegs_Revolute-43" type="continuous">
    <origin xyz="-0.01549999999999999 -0.05876532 0.06650282" rpy="1.5707963267948974 -3.8761492285297827e-31 1.570796326794897" />
    <parent link="BLLegs" />
    <child link="LBWheelColision" />
    <axis xyz="-3.8064789415719646e-16 8.049125398861855e-16 1.0" />
  </joint>
  <joint name="BRLegs_Revolute-44" type="continuous">
    <origin xyz="0.01549999999999999 0.05876532 -0.06650282" rpy="1.5707963267948974 -2.465190328815662e-31 -1.5707963267948961" />
    <parent link="BRLegs" />
    <child link="RBWheelColision" />
    <axis xyz="3.8064789415719646e-16 -8.049125398861855e-16 -1.0" />
  </joint>
  <joint name="FRLegs_Revolute-45" type="continuous">
    <origin xyz="0.01549999999999999 0.05873733 0.06652989999999999" rpy="1.5707963267948974 -2.465190328815662e-31 -1.5707963267948961" />
    <parent link="FRLegs" />
    <child link="RFWheelColision" />
    <axis xyz="3.8064789415719616e-16 -8.049125398861859e-16 -1.0" />
  </joint>
  <joint name="base_link_to_Chassis" type="fixed">
    <origin xyz="-0.06164321620590698 -0.09150000000000008 0.024978117942810095" rpy="0 0 0" />
    <parent link="base_link" />
    <child link="Chassis" />
  </joint>
  <link name="lidar_link" />
  <link name="imu_link" />
  <link name="camera_link" />
  <joint name="Chassis_to_lidar_link" type="fixed">
    <!-- Centered on top of LD06 mesh, 5 mm below mesh top. -->
    <origin xyz="0.21649999620590696 0.09150000000000003 0.11105000205719002" rpy="0 0 0" />
    <parent link="Chassis" />
    <child link="lidar_link" />
  </joint>
  <joint name="Chassis_to_imu_link" type="fixed">
    <!-- Centered on BN0085 mesh; rotated so imu Y points forward (+X chassis) and X points right (-Y chassis). -->
    <origin xyz="0.21582 0.09150 0.07357" rpy="0 0 -1.5707963267948966" />
    <parent link="Chassis" />
    <child link="imu_link" />
  </joint>
  <joint name="Chassis_to_camera_link" type="fixed">
    <origin xyz="0.21499999620590693 0.10189999999999982 0.06275000205719003" rpy="0 0 0" />
    <parent link="Chassis" />
    <child link="camera_link" />
  </joint>
  <!-- VL53 distance sensor scan frame. Its +X axis follows robotarm_x_joint
       (+Y in Gripper frame), matching the Gazebo single-ray distance sensor. -->
  <link name="dist_sensor_link" />
  <joint name="ABX00102_to_dist_sensor_link" type="fixed">
    <origin xyz="0 -0.001606 0" rpy="0 0 -1.5707963267948966" />
    <parent link="ABX00102-Dist-sensor" />
    <child link="dist_sensor_link" />
  </joint>
</robot>
