EmiliamBeke/Mekatronikk-4-MEPA2002/src/robot_gz/models/tracked_robot/model.sdf

<?xml version='1.0' encoding='utf-8'?>
<sdf version="1.7" xmlns:gz="http://gazebosim.org/schema">
    <model name="tracked_robot">
        <link name="base_link">
            <pose>0 0 0 0 0 1.5707963267948972</pose>
        </link>
        <link name="Chassis">
            <pose>0.09150000000000008 -0.06164321620590698 0.024978117942810095 -3.8064789415719685e-16 3.80647894157197e-16 1.5707963267948974</pose>
            <inertial>
                <mass>1.4907690350907317</mass>
                <pose>0.08016056471355223 0.09137425589873138 0.04160371992676176 0.0 0.0 0.0</pose>
                <inertia>
                    <ixx>0.00601805889102517</ixx>
                    <iyy>0.011696228691038965</iyy>
                    <izz>0.015388922827137485</izz>
                    <ixy>2.7577451823444063e-05</ixy>
                    <iyz>6.282850546029949e-06</iyz>
                    <ixz>-0.0002627279587458808</ixz>
                </inertia>
            </inertial>
            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
            <sensor name="camera" type="camera">
                <pose relative_to="camera_link">0 0 0 0 0 0</pose>
                <always_on>true</always_on>
                <update_rate>15</update_rate>
                <visualize>false</visualize>
                <topic>/camera</topic>
                <gz:frame_id>camera_link</gz:frame_id>
                <camera>
                    <horizontal_fov>1.3962634</horizontal_fov>
                    <image>
                        <width>640</width>
                        <height>480</height>
                        <format>R8G8B8</format>
                    </image>
                    <clip>
                        <near>0.02</near>
                        <far>300</far>
                    </clip>
                </camera>
            </sensor>
            <sensor name="imu" type="imu">
                <pose relative_to="imu_link">0 0 0 0 0 0</pose>
                <always_on>true</always_on>
                <update_rate>100</update_rate>
                <topic>/imu/data</topic>
                <gz:frame_id>imu_link</gz:frame_id>
            </sensor>
            <sensor name="lidar" type="gpu_lidar">
                <pose relative_to="lidar_link">0 0 0 0 0 0</pose>
                <always_on>true</always_on>
                <update_rate>10</update_rate>
                <visualize>false</visualize>
                <topic>/lidar</topic>
                <gz:frame_id>base_laser</gz:frame_id>
                <lidar>
                    <scan>
                        <horizontal>
                            <samples>360</samples>
                            <resolution>1</resolution>
                            <min_angle>-3.14159</min_angle>
                            <max_angle>3.14159</max_angle>
                        </horizontal>
                        <vertical>
                            <samples>1</samples>
                            <resolution>1</resolution>
                            <min_angle>0</min_angle>
                            <max_angle>0</max_angle>
                        </vertical>
                    </scan>
                    <range>
                        <min>0.08</min>
                        <max>10.0</max>
                        <resolution>0.01</resolution>
                    </range>
                    <noise>
                        <type>gaussian</type>
                        <mean>0</mean>
                        <stddev>0.01</stddev>
                    </noise>
                </lidar>
            </sensor>
        </link>
        <link name="Mega-wsheeld-v5-1">
            <pose>0.024002657566231798 -0.11200557035662151 0.19470847440548866 0.09552542704236554 6.906036663343288e-16 -3.1415926535897922</pose>
            <inertial>
                <mass>0.11143362473176022</mass>
                <pose>2.6244862814959943e-05 -0.032884354129500054 -0.07280428419151062 0.0 0.0 0.0</pose>
                <inertia>
                    <ixx>9.029579201477785e-05</ixx>
                    <iyy>2.8519640150265962e-05</iyy>
                    <izz>0.00011029745147072469</izz>
                    <ixy>-4.679777323338436e-07</ixy>
                    <iyz>2.0672244187033827e-07</iyz>
                    <ixz>8.150296181407054e-08</ixz>
                </inertia>
            </inertial>
            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
        </link>
        <link name="ABX00102-Dist-sensor">
            <gravity>0</gravity>
            <pose>-0.019999999999976006 0.2417999869809261 0.06356024279029658 -1.5707963267948968 -2.2204460492504156e-16 4.1633363423465674e-17</pose>
            <inertial>
                <mass>0.0016856916739247086</mass>
                <pose>0.020500000000005392 0.01268 0.0008030006799999647 0.0 0.0 0.0</pose>
                <inertia>
                    <ixx>8.76321038478348e-08</ixx>
                    <iyy>2.2299455179065312e-07</iyy>
                    <izz>3.099020216361131e-07</izz>
                    <ixy>-6.854503093534317e-23</ixy>
                    <iyz>3.378072423399017e-21</iyz>
                    <ixz>1.0469984007739633e-23</ixz>
                </inertia>
            </inertial>
            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
            <sensor name="dist_sensor" type="gpu_lidar">
                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
                <pose>0.0205 0.01268 0.001606 0 -1.5707963 0</pose>
                <always_on>true</always_on>
                <update_rate>30</update_rate>
                <visualize>false</visualize>
                <topic>/sim/dist_sensor/scan</topic>
                <gz:frame_id>dist_sensor_link</gz:frame_id>
                <lidar>
                    <scan>
                        <horizontal>
                            <samples>1</samples>
                            <resolution>1</resolution>
                            <min_angle>0</min_angle>
                            <max_angle>0</max_angle>
                        </horizontal>
                        <vertical>
                            <samples>1</samples>
                            <resolution>1</resolution>
                            <min_angle>0</min_angle>
                            <max_angle>0</max_angle>
                        </vertical>
                    </scan>
                    <range>
                        <min>0.005</min>
                        <max>1.0</max>
                        <resolution>0.001</resolution>
                    </range>
                </lidar>
            </sensor>
        </link>
        <link name="LD06_LiDAR-1">
            <pose>-1.335385389568598e-15 0.15485678379409387 0.10772811985020432 1.570796326794897 3.098100421789638e-16 -3.1415926535897927</pose>
            <inertial>
                <mass>0.04311038533159423</mass>
                <pose>0.00010445701714093902 0.015291217328071127 -8.854672379029564e-08 0.0 0.0 0.0</pose>
                <inertia>
                    <ixx>8.243348670481595e-06</ixx>
                    <iyy>8.943004642017882e-06</iyy>
                    <izz>8.17300863134303e-06</izz>
                    <ixy>5.212676289604407e-08</ixy>
                    <iyz>6.855376574530378e-11</iyz>
                    <ixz>-8.999748514436658e-08</ixz>
                </inertia>
            </inertial>
            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
        </link>
        <link name="rps-kamera-v2-2">
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
            <inertial>
                <mass>0.4624031863395291</mass>
                <pose>0.0911999994277953 -0.0716521087620743 0.011209096966485282 0.0 0.0 0.0</pose>
                <inertia>
                    <ixx>0.00014450099573109902</ixx>
                    <iyy>0.00010693073948690417</iyy>
                    <izz>0.00010693073948691599</izz>
                    <ixy>-4.559804067768998e-19</ixy>
                    <iyz>-1.0772397205805828e-19</iyz>
                    <ixz>-1.3055143265239989e-21</ixz>
                </inertia>
            </inertial>
            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
        </link>
        <link name="RFWheelColision-1">
            <pose>-0.18239999942779542 0.18003879515343704 3.1697789340028315e-05 3.6327445817366954e-18 -5.3987765590367846e-17 -1.6653345369377353e-16</pose>
            <inertial>
                <mass>0.4624031863395291</mass>
                <pose>0.09119999942779528 -0.07165210876207422 0.011209096966485279 0.0 0.0 0.0</pose>
                <inertia>
                    <ixx>0.00014450099573110026</ixx>
                    <iyy>0.00010693073948690057</iyy>
                    <izz>0.00010693073948691418</izz>
                    <ixy>8.495541926356189e-19</ixy>
                    <iyz>3.884520644921842e-22</iyz>
                    <ixz>7.10504363813401e-19</ixz>
                </inertia>
            </inertial>
            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
        </link>
        <joint name="Chassis_Revolute-1" type="revolute">
            <pose>-0.07570000000000006 -0.005149000000000186 -0.06997399999999994 0.0 0.0 0.0</pose>
            <parent>Chassis</parent>
            <child>BRLegs</child>
            <axis>
                <xyz expressed_in="__model__">-1.0 -0.0 -0.0</xyz>
                <limit>
                    <lower>0.0</lower>
                    <upper>0.261799</upper>
                    <effort>1000000</effort>
                    <velocity>1000000</velocity>
                </limit>
                <dynamics>
                    <spring_reference>0.18</spring_reference>
                    <spring_stiffness>350</spring_stiffness>
                    <damping>18</damping>
                </dynamics>
            </axis>
        </joint>
        <joint name="Chassis_Revolute-2" type="revolute">
            <pose>-0.07570000000000009 0.04185699999999977 -0.06997799999999992 0.0 0.0 0.0</pose>
            <parent>Chassis</parent>
            <child>FRLegs</child>
            <axis>
                <xyz expressed_in="__model__">-1.0 -0.0 -0.0</xyz>
                <limit>
                    <lower>-0.261799</lower>
                    <upper>0.0</upper>
                    <effort>1000000</effort>
                    <velocity>1000000</velocity>
                </limit>
                <dynamics>
                    <spring_reference>-0.18</spring_reference>
                    <spring_stiffness>350</spring_stiffness>
                    <damping>18</damping>
                </dynamics>
            </axis>
        </joint>
        <joint name="BRLegs_Revolute-3" type="revolute">
            <pose>1.0876207439017302e-07 -9.696648527577383e-08 0.014999999999999996 0.0 0.0 0.0</pose>
            <parent>BRLegs</parent>
            <child>RBWheel</child>
            <axis>
                <xyz expressed_in="__model__">1.0 -0.0 0.0</xyz>
            </axis>
        </joint>
        <joint name="FRLegs_Revolute-4" type="revolute">
            <pose>3.136086366446485e-07 2.0524417449274255e-07 0.014999999999999913 0.0 0.0 0.0</pose>
            <parent>FRLegs</parent>
            <child>RFWheel</child>
            <axis>
                <xyz expressed_in="__model__">-1.0 0.0 -0.0</xyz>
            </axis>
        </joint>
        <joint name="Chassis_Revolute-5" type="revolute">
            <pose>2.1620590681712305e-07 -1.1794280994885455e-07 -0.000499999999999876 0.0 0.0 0.0</pose>
            <parent>Chassis</parent>
            <child>RTWheel</child>
            <axis>
                <xyz expressed_in="__model__">-1.0 -0.0 -0.0</xyz>
            </axis>
        </joint>
        <joint name="Chassis_Revolute-6" type="revolute">
            <pose>2.162059072795424e-07 0.003000000000000055 0.029999882131695906 0.0 0.0 0.0</pose>
            <parent>Chassis</parent>
            <child>RDriveWheel</child>
            <axis>
                <xyz expressed_in="__model__">-1.0 -0.0 -0.0</xyz>
            </axis>
        </joint>
        <joint name="Chassis_Revolute-7" type="revolute">
            <pose>-0.0757 0.041857 0.069978 0.0 0.0 0.0</pose>
            <parent>Chassis</parent>
            <child>FLLegs</child>
            <axis>
                <xyz expressed_in="__model__">1.0 0.0 0.0</xyz>
                <limit>
                    <lower>0.0</lower>
                    <upper>0.261799</upper>
                    <effort>1000000</effort>
                    <velocity>1000000</velocity>
                </limit>
                <dynamics>
                    <spring_reference>0.18</spring_reference>
                    <spring_stiffness>350</spring_stiffness>
                    <damping>18</damping>
                </dynamics>
            </axis>
        </joint>
        <joint name="Chassis_Revolute-8" type="revolute">
            <pose>-0.0757 -0.005149 0.069974 0.0 0.0 0.0</pose>
            <parent>Chassis</parent>
            <child>BLLegs</child>
            <axis>
                <xyz expressed_in="__model__">1.0 0.0 0.0</xyz>
                <limit>
                    <lower>-0.261799</lower>
                    <upper>0.0</upper>
                    <effort>1000000</effort>
                    <velocity>1000000</velocity>
                </limit>
                <dynamics>
                    <spring_reference>-0.18</spring_reference>
                    <spring_stiffness>350</spring_stiffness>
                    <damping>18</damping>
                </dynamics>
            </axis>
        </joint>
        <joint name="FLLegs_Revolute-9" type="revolute">
            <pose>3.136086368499095e-07 2.0524417458202864e-07 -0.01499999999999994 0.0 0.0 0.0</pose>
            <parent>FLLegs</parent>
            <child>LFWheel</child>
            <axis>
                <xyz expressed_in="__model__">1.0 0.0 0.0</xyz>
            </axis>
        </joint>
        <joint name="BLLegs_Revolute-10" type="revolute">
            <pose>1.0876207453994901e-07 -9.696648521540119e-08 -0.01500000000000005 0.0 0.0 0.0</pose>
            <parent>BLLegs</parent>
            <child>LBWheel</child>
            <axis>
                <xyz expressed_in="__model__">1.0 0.0 0.0</xyz>
            </axis>
        </joint>
        <joint name="Chassis_Revolute-11" type="revolute">
            <pose>2.162059074134908e-07 0.002999999999999967 -0.029999882131695944 0.0 0.0 0.0</pose>
            <parent>Chassis</parent>
            <child>LDriveWheel</child>
            <axis>
                <xyz expressed_in="__model__">1.0 0.0 0.0</xyz>
            </axis>
        </joint>
        <joint name="Chassis_Revolute-12" type="revolute">
            <pose>2.1620590703834447e-07 -1.1794280994922448e-07 0.0004999988555908219 0.0 0.0 0.0</pose>
            <parent>Chassis</parent>
            <child>LTWheel</child>
            <axis>
                <xyz expressed_in="__model__">1.0 0.0 0.0</xyz>
            </axis>
        </joint>
        <joint name="Chassis_Rigid-13" type="fixed">
            <pose>-0.023657342433768144 0.005831146445100726 -0.08295083029845894 0.0 0.0 0.0</pose>
            <parent>Chassis</parent>
            <child>Mega-wsheeld-v5-1</child>
        </joint>
        <joint name="Chassis_Rigid-14" type="fixed">
            <pose>3.652959471414381e-18 -2.3557458822019342e-17 0.06830020059327371 0.0 0.0 0.0</pose>
            <parent>Chassis</parent>
            <child>ZStepper</child>
        </joint>
        <joint name="Chassis_Rigid-15" type="fixed">
            <pose>0.03899999999999841 9.988213169561644e-05 0.024500216205909645 0.0 0.0 0.0</pose>
            <parent>Chassis</parent>
            <child>PI5</child>
        </joint>
        <joint name="Chassis_Rigid-16" type="fixed">
            <pose>-0.014100000000001339 -1.1985020431352417e-07 0.014100216205906117 0.0 0.0 0.0</pose>
            <parent>Chassis</parent>
            <child>LD06_LiDAR-1</child>
        </joint>
        <joint name="Chassis_Rigid-17" type="fixed">
            <pose>-0.010159999955668833 -0.008890216205907039 -1.1786830438315194e-07 0.0 0.0 0.0</pose>
            <parent>Chassis</parent>
            <child>BN0085</child>
        </joint>
        <joint name="Chassis_Rigid-18" type="fixed">
            <pose>0.01049999999999983 0.009999882131695654 -0.0009997837940929329 0.0 0.0 0.0</pose>
            <parent>Chassis</parent>
            <child>rps-kamera-v2-2</child>
        </joint>
        <joint name="Chassis_Rigid-19" type="fixed">
            <pose>9.225455665855479e-16 0.048500342907476575 0.03700024190162333 0.0 0.0 0.0</pose>
            <parent>Chassis</parent>
            <child>Unyaktig-batteri-mockup-v1-1</child>
        </joint>
        <joint name="Chassis_Rigid-20" type="fixed">
            <pose>1.3078674767907941e-08 -5.437442680560862e-07 -0.4999997994067263 0.0 0.0 0.0</pose>
            <parent>Chassis</parent>
            <child>RLeadscrew</child>
        </joint>
        <joint name="Chassis_Rigid-21" type="fixed">
            <pose>1.3078674809542182e-08 -5.437443178322416e-07 0.4999997994067263 0.0 0.0 0.0</pose>
            <parent>Chassis</parent>
            <child>LLeadscrew</child>
        </joint>
        <joint name="robotarm_z_joint" type="prismatic">
            <pose>0.011000013078674568 -0.027999999999975277 0.36000020059327364 0.0 0.0 0.0</pose>
            <parent>RLeadscrew</parent>
            <child>Leadscrew-Rigg</child>
            <axis>
                <xyz expressed_in="__model__">-0.0 0.0 1.0</xyz>
                <limit>
                    <lower>0.0</lower>
                    <upper>0.25</upper>
                    <effort>10000</effort>
                    <velocity>1.0</velocity>
                </limit>
                <dynamics>
                    <damping>0.1</damping>
                    <friction>0.0</friction>
                </dynamics>
            </axis>
        </joint>
        <joint name="Leadscrew-Rigg_Rigid-23" type="fixed">
            <pose>1.3078674684918692e-08 2.4882873463663903e-14 2.0059327376920088e-07 0.0 0.0 0.0</pose>
            <parent>Leadscrew-Rigg</parent>
            <child>LeadNutR</child>
        </joint>
        <joint name="Leadscrew-Rigg_Rigid-25" type="fixed">
            <pose>2.0059327376043226e-07 -1.3078678939003943e-08 0.02650000095367519 0.0 0.0 0.0</pose>
            <parent>Leadscrew-Rigg</parent>
            <child>Xstepper</child>
        </joint>
        <joint name="Leadscrew-Rigg_Revolute-26" type="fixed">
            <pose>2.005932737414451e-07 1.3078678747641056e-08 2.490108805554369e-14 0.0 0.0 0.0</pose>
            <parent>Leadscrew-Rigg</parent>
            <child>Stepper-Gear-9R24.00-m2.741-1</child>
        </joint>
        <joint name="Chassis_Rigid-27" type="fixed">
            <pose>-0.06509998692132508 0.016500000476875148 -0.09649979749937762 0.0 0.0 0.0</pose>
            <parent>Chassis</parent>
            <child>StøtteStag-1</child>
        </joint>
        <joint name="Leadscrew-Rigg_Revolute-28" type="fixed">
            <pose>1.3078678931521747e-08 -2.005932737414453e-07 2.484470953658883e-14 0.0 0.0 0.0</pose>
            <parent>Leadscrew-Rigg</parent>
            <child>Gear-9R24.00-m2.741-1-1</child>
        </joint>
        <joint name="robotarm_x_joint" type="prismatic">
            <pose>-2.4501307459178207e-14 -0.1670749869809259 0.15480988205718993 0.0 0.0 0.0</pose>
            <parent>Leadscrew-Rigg</parent>
            <child>Gripper</child>
            <axis>
                <xyz expressed_in="__model__">-0.0 1.0 -0.0</xyz>
                <limit>
                    <lower>-0.07</lower>
                    <upper>0.082</upper>
                    <effort>1000</effort>
                    <velocity>1.0</velocity>
                </limit>
                <dynamics>
                    <damping>1.0</damping>
                    <friction>0.1</friction>
                </dynamics>
            </axis>
        </joint>
        <joint name="Gripper_Rigid-30" type="fixed">
            <pose>-2.4405824609706215e-14 0.010000013019074118 -1.1794280986889988e-07 0.0 0.0 0.0</pose>
            <parent>Gripper</parent>
            <child>Servo</child>
        </joint>
        <joint name="Gripper_Rigid-31" type="fixed">
            <pose>0.020499999999975982 0.012680242790296581 1.3019073877929347e-08 0.0 0.0 0.0</pose>
            <parent>Gripper</parent>
            <child>ABX00102-Dist-sensor</child>
        </joint>
        <joint name="Servo_Revolute-32" type="fixed">
            <pose>1.1794280984486783e-07 -2.4392068598674702e-14 -0.00021801301907406473 0.0 0.0 0.0</pose>
            <parent>Servo</parent>
            <child>Servo-Gear-8L30.00-m2.1651</child>
        </joint>
        <joint name="Gripper_Slider-33" type="fixed">
            <pose>0.10878198265449869 -0.0013751190815026717 -0.007999882057190062 0.0 0.0 0.0</pose>
            <parent>Gripper</parent>
            <child>Top-Rack-200.0mm-R30.00-m2.1651</child>
        </joint>
        <joint name="Gripper_Slider-34" type="fixed">
            <pose>-0.10858271791413462 0.0013752315894712268 -0.00800011794280983 0.0 0.0 0.0</pose>
            <parent>Gripper</parent>
            <child>Bottom-Rack-200.0mm-L30.00-m2.1651</child>
        </joint>
        <joint name="right_gripper_finger_joint" type="revolute">
            <pose>-5.18933657783551e-08 2.9430204269261924e-07 -0.03193738277245858 0.0 0.0 0.0</pose>
            <parent>Gripper</parent>
            <child>Finger-R16L30.00-m2.1651Mirror</child>
            <axis>
                <xyz expressed_in="__model__">0.0 -0.0 -1.0</xyz>
                <limit>
                    <lower>0.0</lower>
                    <upper>8.0</upper>
                    <effort>1000</effort>
                    <velocity>10.0</velocity>
                </limit>
                <dynamics>
                    <damping>0.5</damping>
                    <friction>0.05</friction>
                </dynamics>
            </axis>
        </joint>
        <joint name="left_gripper_finger_joint" type="revolute">
            <pose>-1.4942103989005114e-07 -2.588048814805392e-07 0.018062382295621567 0.0 0.0 0.0</pose>
            <parent>Gripper</parent>
            <child>Finger-L-16L30.00-m2.1651</child>
            <axis>
                <xyz expressed_in="__model__">0.0 -0.0 -1.0</xyz>
                <limit>
                    <lower>0.0</lower>
                    <upper>8.0</upper>
                    <effort>1000</effort>
                    <velocity>10.0</velocity>
                </limit>
                <dynamics>
                    <damping>0.5</damping>
                    <friction>0.05</friction>
                </dynamics>
            </axis>
        </joint>
        <joint name="Chassis_Rigid-37" type="fixed">
            <pose>2.162059072204627e-07 -0.053000000000000116 -0.006999882131695907 0.0 0.0 0.0</pose>
            <parent>Chassis</parent>
            <child>M1</child>
        </joint>
        <joint name="Chassis_Rigid-38" type="fixed">
            <pose>2.1620590707963082e-07 -0.05299999999999997 0.006999882131695894 0.0 0.0 0.0</pose>
            <parent>Chassis</parent>
            <child>M2</child>
        </joint>
        <joint name="Leadscrew-Rigg_Rigid-39" type="fixed">
            <pose>1.3078674740429903e-08 2.4865526228904132e-14 2.0059327368593415e-07 0.0 0.0 0.0</pose>
            <parent>Leadscrew-Rigg</parent>
            <child>LeadNutL</child>
        </joint>
        <joint name="Chassis_Rigid-40" type="fixed">
            <pose>0.10670000000000006 0.01838634604993215 0.08510295503333694 0.0 0.0 0.0</pose>
            <parent>Chassis</parent>
            <child>LTracks</child>
        </joint>
        <joint name="Chassis_Rigid-41" type="fixed">
            <pose>0.07569999999999992 0.018386346049931963 0.08510295503333666 0.0 0.0 0.0</pose>
            <parent>Chassis</parent>
            <child>RTracks</child>
        </joint>
        <joint name="FLLegs_Revolute-42" type="revolute">
            <pose>0.09119999942779534 -0.07165179515343696 0.011209302210659964 0.0 0.0 0.0</pose>
            <parent>FLLegs</parent>
            <child>RFWheelColision-1</child>
            <axis>
                <xyz expressed_in="__model__">-1.0 -0.0 -0.0</xyz>
            </axis>
        </joint>
        <joint name="BLLegs_Revolute-43" type="revolute">
            <pose>0.09119999942779528 -0.0716519999999995 0.011209000000000243 0.0 0.0 0.0</pose>
            <parent>BLLegs</parent>
            <child>LBWheelColision</child>
            <axis>
                <xyz expressed_in="__model__">1.0 0.0 0.0</xyz>
            </axis>
        </joint>
        <joint name="BRLegs_Revolute-44" type="revolute">
            <pose>0.09119999942779536 -0.07165199999999973 0.011209000000000127 0.0 0.0 0.0</pose>
            <parent>BRLegs</parent>
            <child>RBWheelColision</child>
            <axis>
                <xyz expressed_in="__model__">1.0 -0.0 0.0</xyz>
            </axis>
        </joint>
        <joint name="FRLegs_Revolute-45" type="revolute">
            <pose>0.0911999994277953 -0.07165179515343749 0.01120930221065989 0.0 0.0 0.0</pose>
            <parent>FRLegs</parent>
            <child>RFWheelColision</child>
            <axis>
                <xyz expressed_in="__model__">1.0 -0.0 0.0</xyz>
            </axis>
        </joint>

        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
        <joint name="base_link_to_Chassis" type="fixed">
            <parent>base_link</parent>
            <child>Chassis</child>
        </joint>

        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
        <frame name="camera_link" attached_to="Chassis">
            <pose>0.2149999962059069 0.1018999999999998 0.06275000205719003 0 0 0</pose>
        </frame>
        <frame name="imu_link" attached_to="Chassis">
            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
            <pose>0.21582 0.09150 0.07357 0 0 -1.5707963267948966</pose>
        </frame>
        <frame name="lidar_link" attached_to="Chassis">
            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
            <pose>0.21649999620590696 0.09150000000000003 0.11105000205719002 0 0 0</pose>
        </frame>
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
