EmiliamBeke/Mekatronikk-4-MEPA2002/frames_2026-04-23_21.14.02.pdf

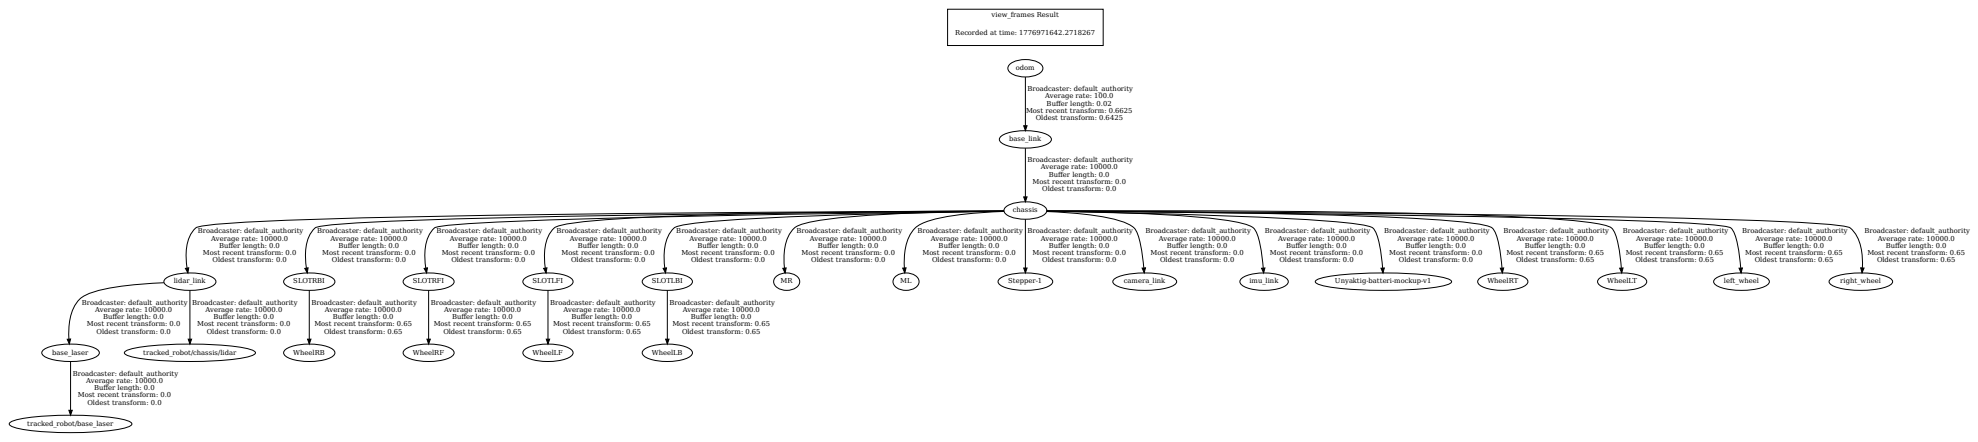
[picture p29: page 1]
view_frames Result; base_laser; tracked_robot/base_laser; lidar_link; tracked_robot/chassis/lidar; chassis; SLOTRBI; SLOTRFI; SLOTLFI; SLOTLBI; Stepper-1; camera_link; imu_link; WheelRT; WheelLT; left_wheel; right_wheel; WheelRB; base_link; WheelRF; WheelLF; WheelLB; odom

Recorded at time: 1776971642.2718267

Broadcaster: default_authority
Average rate: 100.0
Buffer length: 0.02
Most recent transform: 0.6625
Oldest transform: 0.6425

Average rate: 10000.0
Buffer length: 0.0
Most recent transform: 0.0
Oldest transform: 0.0

Most recent transform: 0.65
Oldest transform: 0.65

Unyaktig-batteri-mockup-v1
