EmiliamBeke/Mekatronikk-4-MEPA2002/config/robotarm_params.yaml

mega_driver:
  ros__parameters:
    # Serial connection and command loop timing.
    port: /dev/ttyACM0
    baudrate: 115200
    post_open_wait_s: 2.5
    startup_ready_timeout_s: 120.0
    reconnect_delay_s: 1.0
    send_period_s: 0.2
    reply_timeout_s: 2.0
    cmd_vel_timeout_s: 0.5
    max_driver_errors_before_reconnect: 10

    # Base frames and odometry. Pi launch overrides publish_tf via mega_publish_tf
    # arg. Default false because EKF owns odom->base_link in normal bringup; sim
    # launch sets it true explicitly when needed.
    base_frame_id: base_link
    odom_frame_id: odom
    publish_tf: false
    odom_poll_period_s: 0.05
    odom_tf_hold_timeout_s: 1.75
    reset_odom_after_arm_motion: true
    left_m_per_tick:  0.000054145
    right_m_per_tick: 0.000053178
    track_width_eff_m: 0.289845896
    left_tick_sign: 1
    right_tick_sign: 1
    reset_encoders_on_connect: true

    # Track motor command conversion. Pi launch can override these during
    # hardware calibration without editing code.
    swap_sides: false
    max_track_speed_mps: 0.45
    max_pwm: 255
    min_nonzero_pwm: 50
    min_forward_pwm: 50
    min_reverse_pwm: 60
    min_turn_pwm: 90
    pure_rotation_linear_deadband_mps: 0.03
    left_cmd_sign: 1
    right_cmd_sign: 1
    angular_cmd_sign: -1
    left_cmd_scale: 0.96
    right_cmd_scale: 1.0

    # Mega-side conversion from requested arm position in meters to firmware steps.
    # Must match the mechanical setup and the constants in the Mega runtime firmware.
    arm_x_steps_per_mm: 18.65
    arm_z_steps_per_mm: 2929.0
    joint_states_topic: /joint_states
    x_joint_name: robotarm_x_joint
    z_joint_name: robotarm_z_joint

    # Assumed arm state before Mega reports a homed state.
    # Must match HOME ARM in mega_total_code_nonblocking.
    initial_arm_x_m: -0.07
    initial_arm_z_m: 0.13

    # Polling for Mega STATE feedback. Lower values increase serial load and can
    # disturb smooth arm stepping on the Arduino.
    arm_state_poll_period_s: 0.25
    arm_motion_timeout_s: 180.0
    auto_home_x_on_connect: true
    require_arm_home_before_motion: true
    init_distance_sensor_on_connect: true

    # Servo pulse range used by the gripper command path.
    # Servo: 0-270 degrees maps to 500-2500 us. ~1800 us = teddy grip position.
    gripper_min_us: 500
    gripper_max_us: 2500

robotarm_safety:
  ros__parameters:
    # Request topics are written by teleop, teddy_grab, and any high-level arm logic.
    x_request_topic: /robotarm/request/x_position
    z_request_topic: /robotarm/request/z_position
    left_gripper_request_topic: /gripper/request/left_position
    right_gripper_request_topic: /gripper/request/right_position

    # Command topics go to the Mega driver.
    x_command_topic: /robotarm/x_position_cmd
    z_command_topic: /robotarm/z_position_cmd
    left_gripper_command_topic: /gripper/left_position_cmd
    right_gripper_command_topic: /gripper/right_position_cmd

    # Feedback from Mega driver.
    x_state_topic: /robotarm/x_position_state
    z_state_topic: /robotarm/z_position_state
    joint_states_topic: /joint_states
    x_joint_name: robotarm_x_joint
    z_joint_name: robotarm_z_joint

    publish_period_s: 0.05

    # Allowed commanded workspace in meters. Matches minimal_all.launch.py.
    x_min: -0.07
    x_max: 0.082
    z_min: 0.0
    z_max: 0.25

    # Max target jump per publish. Physical speed is set by the Mega firmware;
    # these are large to avoid chopping one smooth arm move into many serial commands.
    max_x_step_per_publish: 0.20
    max_z_step_per_publish: 0.30

    # Keepout to avoid moving low over the LiDAR/front structure.
    lidar_x_threshold: 0.0
    lidar_z_clearance: 0.13

    # Chassis keepout in internal joint coordinates. GUI z=0 maps to joint z=0.13,
    # so if display Z is below 0, x must not retract behind 0.
    chassis_x_min_when_low_z: 0.0
    chassis_z_threshold: 0.13

    # Gripper pulse clamp in microseconds.
    # Servo: 0-270 degrees = 500-2500 us; ~1800 us = teddy grip.
    gripper_min: 500.0
    gripper_max: 2500.0

    # Startup command state before feedback arrives.
    initial_x: -0.07
    initial_z: 0.13
    initial_left_gripper: 500.0
    initial_right_gripper: 500.0

    # On launch, move/hold Z at home before retracting X to home (-0.07).
    startup_lock_s: 1.5
    startup_z_first_x: 0.0
    spawn_x: -0.07
    spawn_z: 0.13
