EmiliamBeke/Mekatronikk-4-MEPA2002/src/robot_bringup/rviz/rviz.rviz.yaml

Panels:
  - Class: rviz_common/Displays
    Help Height: 0
    Name: Displays
    Property Tree Widget:
      Expanded:
        - /Global Options1
        - /Camera1
        - /LaserScan1
        - /Odometry1
        - /RobotModel1
        - /Global Plan1
        - /Local Plan1
        - /Footprint1
        - /TF1
      Splitter Ratio: 0.56
    Tree Height: 720
  - Class: rviz_common/Selection
    Name: Selection
  - Class: rviz_common/Tool Properties
    Expanded:
      - /2D Goal Pose1
    Name: Tool Properties
    Splitter Ratio: 0.58
  - Class: rviz_common/Views
    Expanded:
      - /Current View1
    Name: Views
    Splitter Ratio: 0.5
  - Class: rviz_common/Time
    Experimental: false
    Name: Time
    SyncMode: 0
    SyncSource: LaserScan
Visualization Manager:
  Class: ""
  Displays:
    - Alpha: 0.5
      Cell Size: 0.5
      Class: rviz_default_plugins/Grid
      Color: 160; 160; 164
      Enabled: true
      Line Style:
        Line Width: 0.03
        Value: Lines
      Name: Grid
      Normal Cell Count: 0
      Offset:
        X: 0
        Y: 0
        Z: 0
      Plane: XY
      Plane Cell Count: 20
      Reference Frame: <Fixed Frame>
      Value: true
    - Class: rviz_default_plugins/Image
      Enabled: true
      Max Value: 1
      Median window: 5
      Min Value: 0
      Name: Camera
      Normalize Range: true
      Topic:
        Depth: 5
        Durability Policy: Volatile
        History Policy: Keep Last
        Reliability Policy: Reliable
        Value: /camera
      Value: true
    - Alpha: 1
      Autocompute Intensity Bounds: true
      Autocompute Value Bounds:
        Max Value: 10
        Min Value: -10
        Value: true
      Axis: Z
      Channel Name: intensity
      Class: rviz_default_plugins/LaserScan
      Color: 255; 255; 255
      Color Transformer: Intensity
      Decay Time: 0
      Enabled: true
      Invert Rainbow: false
      Max Color: 255; 255; 255
      Max Intensity: 0
      Min Color: 0; 0; 0
      Min Intensity: 0
      Name: LaserScan
      Position Transformer: XYZ
      Selectable: true
      Size (Pixels): 3
      Size (m): 0.02
      Style: Points
      Topic:
        Depth: 5
        Durability Policy: Volatile
        Filter size: 10
        History Policy: Keep Last
        Reliability Policy: Best Effort
        Value: /lidar
      Use Fixed Frame: true
      Use rainbow: true
      Value: true
    - Alpha: 1
      Class: rviz_default_plugins/RobotModel
      Collision Enabled: false
      Description File: ""
      Description Source: Topic
      Description Topic:
        Depth: 5
        Durability Policy: Volatile
        History Policy: Keep Last
        Reliability Policy: Reliable
        Value: /robot_description
      Enabled: true
      Links:
        All Links Enabled: true
        Expand Joint Details: false
        Expand Link Details: false
        Expand Tree: false
        Link Tree Style: Links in Alphabetic Order
      Mass Properties:
        Inertia: false
        Mass: false
      Name: RobotModel
      TF Prefix: ""
      Update Interval: 0
      Value: true
      Visual Enabled: true
    - Angle Tolerance: 0.1
      Class: rviz_default_plugins/Odometry
      Covariance:
        Orientation:
          Alpha: 0.5
          Color: 255; 255; 127
          Color Style: Unique
          Frame: Local
          Offset: 1
          Scale: 1
          Value: true
        Position:
          Alpha: 0.3
          Color: 204; 51; 204
          Scale: 1
          Value: true
        Value: true
      Enabled: true
      Keep: 200
      Name: Odometry
      Position Tolerance: 0.1
      Shape:
        Alpha: 1
        Axes Length: 0.4
        Axes Radius: 0.03
        Color: 255; 25; 0
        Head Length: 0.08
        Head Radius: 0.04
        Shaft Length: 0.2
        Shaft Radius: 0.02
        Value: Arrow
      Topic: /odom
      Unreliable: false
      Value: true
    - Alpha: 1
      Buffer Length: 1
      Class: rviz_default_plugins/Path
      Color: 255; 0; 0
      Enabled: true
      Head Diameter: 0.03
      Head Length: 0.03
      Length: 0.3
      Line Style: Lines
      Line Width: 0.03
      Name: Global Plan
      Offset:
        X: 0
        Y: 0
        Z: 0
      Pose Color: 255; 85; 255
      Pose Style: Arrows
      Radius: 0.03
      Shaft Diameter: 0.01
      Shaft Length: 0.03
      Topic:
        Depth: 5
        Durability Policy: Volatile
        Filter size: 10
        History Policy: Keep Last
        Reliability Policy: Reliable
        Value: /plan
      Value: true
    - Alpha: 1
      Buffer Length: 1
      Class: rviz_default_plugins/Path
      Color: 0; 64; 255
      Enabled: true
      Head Diameter: 0.1
      Head Length: 0.05
      Length: 0.25
      Line Style: Lines
      Line Width: 0.03
      Name: Local Plan
      Offset:
        X: 0
        Y: 0
        Z: 0
      Pose Color: 255; 85; 255
      Pose Style: None
      Radius: 0.03
      Shaft Diameter: 0.05
      Shaft Length: 0.05
      Topic:
        Depth: 5
        Durability Policy: Volatile
        Filter size: 10
        History Policy: Keep Last
        Reliability Policy: Reliable
        Value: /local_plan
      Value: true
    - Alpha: 1
      Class: rviz_default_plugins/Polygon
      Color: 25; 255; 0
      Enabled: true
      Name: Footprint
      Topic:
        Depth: 5
        Durability Policy: Volatile
        Filter size: 10
        History Policy: Keep Last
        Reliability Policy: Reliable
        Value: /local_costmap/published_footprint
      Value: true
    - Class: rviz_default_plugins/TF
      Enabled: true
      Filter (blacklist): ""
      Filter (whitelist): ""
      Frame Timeout: 15
      Frames:
        All Enabled: true
      Marker Scale: 0.4
      Name: TF
      Show Arrows: true
      Show Axes: true
      Show Names: false
      Tree:
        {}
      Update Interval: 0
      Value: true
  Enabled: true
  Global Options:
    Background Color: 48; 48; 48
    Fixed Frame: odom
    Frame Rate: 30
  Name: root
  Tools:
    - Class: rviz_default_plugins/Interact
      Hide Inactive Objects: true
    - Class: rviz_default_plugins/MoveCamera
    - Class: rviz_default_plugins/Select
    - Class: rviz_default_plugins/FocusCamera
    - Class: rviz_default_plugins/Measure
      Line color: 128; 128; 0
    - Class: rviz_default_plugins/SetGoal
      Topic:
        Depth: 5
        Durability Policy: Volatile
        History Policy: Keep Last
        Reliability Policy: Reliable
        Value: /goal_pose
  Transformation:
    Current:
      Class: rviz_default_plugins/TF
  Value: true
  Views:
    Current:
      Class: rviz_default_plugins/Orbit
      Distance: 3
      Enable Stereo Rendering:
        Stereo Eye Separation: 0.06
        Stereo Focal Distance: 1
        Swap Stereo Eyes: false
        Value: false
      Focal Point:
        X: 0
        Y: 0
        Z: 0.1
      Focal Shape Fixed Size: true
      Focal Shape Size: 0.05
      Invert Z Axis: false
      Name: Current View
      Near Clip Distance: 0.01
      Pitch: 1.05
      Target Frame: odom
      Value: Orbit (rviz)
      Yaw: 0.8
