EmiliamBeke/Mekatronikk-4-MEPA2002/config/camera_params.yaml

# Camera capture settings on the Pi host.
# These affect the encoded stream that is sent to both teddy_detector and RViz.
# After changing this file:
# - use `make camera-reload` for color/exposure/FPS/encoder tuning
# - do a full Pi restart for width/height/UDP port changes
camera_stream:
  # Output resolution from the Pi camera.
  # Higher values improve detail, but increase CPU load, bandwidth, and delay.
  width: 800
  height: 600

  # Capture framerate.
  # Lower FPS usually reduces delay and makes the stream easier to keep stable.
  fps: 6

  # Optional H.264 bitrate in bits/sec.
  # Leave empty to use the rpicam default.
  # Lower bitrate reduces bandwidth, but can increase compression artifacts.
  bitrate_bps: 2800000

  # Optional I-frame interval in frames.
  # Lower values recover faster from UDP packet loss, but use more bitrate.
  # A good starting point is around the same as FPS, e.g. 10 at 10 FPS.
  # Leave empty for the encoder default if the stream becomes choppy.
  intra: 6

  # Try to reduce encoder delay on newer Pi camera stacks.
  # If your rpicam build is too old, the script will ignore this and warn once.
  # This can make the stream less stable on marginal Wi-Fi links, so default is false.
  low_latency: True

  # Flush encoded output as frames are written.
  # This is useful when piping H.264 through a FIFO to GStreamer.
  flush_output: false

  # Small RTP jitter buffer on the PC side, in milliseconds.
  # Higher smooths Wi-Fi jitter and reduces artifacts, but adds delay.
  # Lower reduces delay, but can increase choppiness.
  pc_jitter_ms: 10

  # Local UDP port used by teddy_detector on the Pi.
  local_udp_port: 5600

  # Auto white balance mode.
  # Common values: auto, indoor, daylight, cloudy.
  awb: auto

  # Fixed white-balance gains as "red_gain,blue_gain".
  # Leave empty to keep automatic AWB behaviour.
  awb_gains: ""

  # Global brightness offset. Keep near 0.0 unless the whole image is too dark/bright.
  brightness: 0.0

  # Contrast multiplier. Slightly above 1.0 can make the image feel less flat.
  contrast: 1.0

  # Color intensity multiplier. 1.0 is neutral.
  saturation: 1.0

  # Edge enhancement. Too high can make noise and ringing more visible.
  sharpness: 0.8

  # Exposure compensation. Useful if auto exposure is consistently too dark/bright.
  ev: 0.0

  # Denoise mode.
  # Quote values like "off" or "on" so YAML does not treat them as booleans.
  # Valid practical values here: "auto", "off", "cdn_off", "cdn_fast", "cdn_hq", "on".
  denoise: "cdn_hq"

  # Exposure metering mode. "centre" is a safe default for robot driving indoors.
  metering: centre

  # Optional custom libcamera tuning JSON.
  # Leave empty unless you have a known-good tuning file for this sensor.
  tuning_file: ""

# YOLO / teddy detector tuning on the Pi.
teddy_detector:
  # NCNN model path inside the Docker workspace on the Pi.
  model_path: /ws/models/yolo26n_ncnn_model

  # Detection confidence threshold.
  # Lower catches more teddy detections, but increases false positives.
  conf: 0.3

  # YOLO inference size. Higher can improve detection quality, but costs latency/CPU.
  imgsz: 640

  # Allowed center error before reporting centered=true.
  center_tol: 0.10

  # Seconds between detector status log lines. Set 0 to disable these logs.
  status_log_period_sec: 10.0

  # Debug GUI on the Pi host. Keep false for headless SSH use.
  show_gui: false

  # Stream annotated YOLO output as H264/UDP from the Pi.
  # This is the recommended way to view detections on the PC.
  stream_debug_video: true

  # UDP port for the annotated YOLO stream.
  debug_stream_port: 5602

  # Scale factor before H264 encoding the annotated stream.
  # 1.0 keeps full input size, 0.5 halves width and height.
  debug_stream_scale: 1.0

  # Output FPS for the annotated YOLO stream.
  # This is a max rate, not a guaranteed rate.
  # Set it close to the detector's actual Hz, or use "auto" to let the
  # stream follow the actual YOLO/inference rate without extra throttling.
  debug_stream_fps: auto

  # H264 bitrate for the annotated YOLO stream.
  debug_stream_bitrate_bps: 1400000
