EmiliamBeke/Mekatronikk-4-MEPA2002/config/teddy_approach.yaml

teddy_approach:
  ros__parameters:
    enabled: true
    status_topic: /teddy_detector/status
    cmd_vel_topic: /cmd_vel_teddy
    mode_topic: /teddy_approach/mode
    reset_topic: /teddy_approach/reset
    publish_period_s: 0.05
    lost_timeout_s: 0.5
    # Max age of a detection before turn commands are suppressed (but teddy not
    # considered lost). Keeps the node from acting on stale frames when the
    # camera lags. Must be <= lost_timeout_s.
    detection_act_timeout_s: 0.25

    # Image centering regulator. dx > 0 means teddy is right of image center.
    # angular_kd=0.0 gives a plain P regulator; raise it only if heading overshoots.
    angular_kp: 0.2
    angular_kd: 0.2
    max_angular_speed: 1.5
    min_angular_speed: 0.9
    center_tolerance: 0.10
    center_settle_s: 2.0

    # Stop when YOLO is centered and LiDAR sees something close straight ahead.
    scan_topic: /lidar
    stop_lidar_distance_m: 0.16
    stop_lidar_front_angle_rad: 0.20
    stop_lidar_min_points: 3
    stop_lidar_timeout_s: 1.5

    # Drive forward only after the teddy is centered unless this is true.
    linear_speed: 0.05
    drive_when_not_centered: false

teddy_lidar_markers:
  ros__parameters:
    enabled: true
    status_topic: /teddy_detector/status
    scan_topic: /lidar
    marker_topic: /teddy_approach/lidar_stop_markers

    # Publish markers in a stable frame with TF to odom.
    marker_frame_id: base_laser
    # Use latest TF in RViz to avoid future-extrapolation warnings.
    marker_use_latest_tf: true

    stop_lidar_distance_m: 0.16
    stop_lidar_front_angle_rad: 0.20

teddy_nav_goal:
  ros__parameters:
    enabled: true
    send_goal_on_start: false
    goal_frame: odom
    goal_x: 0.0
    goal_y: 0.0
    goal_yaw: 0.0
