EmiliamBeke/Mekatronikk-4-MEPA2002/config/teddy_grab.yaml

teddy_grab:
  ros__parameters:
    enabled: true
    mode_topic: /teddy_approach/mode
    approach_reset_topic: /teddy_approach/reset
    trigger_mode: teddy_approach_settled

    # While the arm is grabbing, publish zero velocity on the same assist topic
    # Nav2 uses for teddy approach. This keeps the base stopped through cmd_vel_mux.
    cmd_vel_topic: /cmd_vel_teddy
    stop_base_while_active: true

    # Feedback from Mega driver.
    x_state_topic: /robotarm/x_position_state
    z_state_topic: /robotarm/z_position_state
    distance_topic: /mega/distance_mm
    teddy_status_topic: /teddy_detector/status
    scan_topic: /lidar

    publish_period_s: 0.05
    position_tolerance_m: 0.003
    distance_timeout_s: 0.5
    detector_status_timeout_s: 1.0
    scan_timeout_s: 0.5
    status_log_period_s: 0.5
    require_state_feedback: true

    # Sequence positions in meters. Same physical coordinates as Mega STATE X/Z.
    # Mega home/retracted X is -0.07. X must move to safe_x before lowering Z.
    safe_x: 0.01
    home_x: -0.07
    lower_z: 0.03
    approach_x_max: 0.082
    approach_x_step_m: 0.002
    lift_z: 0.21
    home_z: 0.13

    # Extend X outward from safe_x until distance contact is stable or the
    # configured mechanical reach limit is reached.
    require_distance_feedback: true
    contact_distance_mm: 50
    contact_hold_s: 2.0

    # Optional rough image-to-height correction from teddy_detector dy only.
    # This is empirical, not geometric calibration.
    use_detector_dy_for_grab_z: true
    dy_to_z_gain_m: 0.04

    # Preferred pre-grab Z estimate: sample teddy_detector dy and front LiDAR
    # before the gripper blocks the camera. The formula is:
    # z = origin + sign * lidar_m * tan(camera_pitch_down + dy * vertical_fov/2) + offset
    # Positive dy means teddy center is below image center.
    use_lidar_geometry_for_grab_z: true
    scan_front_angle_rad: 0.20
    scan_min_points: 3
    camera_vertical_fov_rad: 0.80
    camera_pitch_down_rad: 0.0
    lidar_geometry_z_origin_m: 0.01
    lidar_geometry_z_sign: -1.0
    lidar_geometry_z_offset_m: 0.0
    grab_z_min: 0.0
    grab_z_max: 0.12

    # Servo pulse widths in microseconds.
    gripper_open: 500.0
    gripper_closed: 1800.0

    # Per-step hold times.
    move_hold_s: 1.0
    grab_hold_s: 2.0
    verify_hold_s: 1.0
    final_hold_s: 1.0

    # Wait this long after teddy_approach reports stop before moving the arm.
    # Lets the chassis fully decelerate.
    settle_after_trigger_s: 2.0
