EmiliamBeke/Mekatronikk-4-MEPA2002/(commit log)

2026-02-07 modified: docker/Dockerfile new file: yolo26n.pt new file: yolo26n_ncnn_model/metadata.yaml new file: yolo26n_ncnn_model/model.ncnn.bin new file: yolo26n_ncnn_model/model.ncnn.param new file: yolo26n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
    [model.ncnn.param]
2026-02-09 modified: compose.yml modified: docker/Dockerfile new file: src/mekk4_bringup/launch/camera.launch.py modified: src/mekk4_bringup/package.xml modified: src/mekk4_perception/mekk4_perception/teddy_det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
2026-02-09 modified: repos/libcamera_ros.repos modified: src/mekk4_bringup/launch/camera.launch.py modified: src/mekk4_bringup/package.xml
2026-02-09 modified: Makefile modified: compose.yml modified: docker/Dockerfile deleted: scripts/vision_stream.sh deleted: src/mekk4_bringup/launch/camera.launch.py deleted: src/mekk4_bringup/launch/vision.laun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
2026-03-12 modified: scripts/lidar_smoketest.sh modified: scripts/setup_ldlidar_driver.sh
2026-03-12 modified: README.md modified: scripts/lidar_smoketest.sh modified: scripts/setup_ldlidar_driver.sh modified: src/robot_bringup/launch/lidar_nav2_compat.launch.py
2026-03-16 modified: docs/lidar_rviz.md new file: src/robot_bringup/rviz/pre_odom_lidar.rviz
2026-03-16 modified: README.md modified: config/camera_params.yaml modified: docs/lidar_rviz.md modified: scripts/camera_config_env.py modified: scripts/camera_udp_stream.sh modified: scripts/vision_stream.sh
2026-03-16 modified: config/camera_params.yaml
2026-03-16 modified: Makefile new file: scripts/camera_stop.sh modified: scripts/camera_udp_stream.sh modified: scripts/pi_bringup.sh
2026-03-16 modified: Makefile modified: config/camera_params.yaml new file: scripts/camera_reload.sh modified: scripts/camera_stop.sh new file: scripts/camera_stream_supervisor.sh modified: scripts/pi_bringup.sh
2026-03-16 modified: config/camera_params.yaml modified: scripts/camera_config_env.py modified: scripts/camera_udp_stream.sh
2026-03-16 modified: config/camera_params.yaml modified: scripts/camera_config_env.py modified: scripts/pc_camera_rviz.sh modified: src/mekk4_bringup/launch/pc_camera_view.launch.py
2026-03-16 modified: Makefile modified: config/camera_params.yaml modified: scripts/camera_config_env.py modified: scripts/camera_udp_stream.sh modified: scripts/pc_camera_rviz.sh new file: scripts/pc_teddy_rvi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
2026-03-16 modified: Makefile modified: README.md modified: docs/lidar_rviz.md deleted: scripts/vision_stream.sh deleted: src/mekk4_bringup/launch/vision_stream.launch.py
2026-03-16 modified: Makefile modified: README.md new file: arduino/mega_dfr0601_test/mega_dfr0601_test.ino new file: scripts/mega_motor_test.py new file: scripts/mega_motor_test.sh
2026-03-16 modified: README.md modified: arduino/mega_dfr0601_test/mega_dfr0601_test.ino modified: scripts/mega_motor_test.py
2026-03-17 modified: Makefile modified: arduino/mega_dfr0601_test/mega_dfr0601_test.ino new file: arduino/mega_keyboard_drive/mega_keyboard_drive.ino new file: scripts/mega_keyboard_teleop.py new file: scripts/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
2026-03-17 modified: arduino/mega_keyboard_drive/mega_keyboard_drive.ino modified: scripts/mega_keyboard_gui.py modified: scripts/mega_keyboard_teleop.py modified: scripts/mega_serial_stdin.py
2026-03-19 modified: compose.yml modified: docker/Dockerfile modified: scripts/pi_bringup.sh new file: src/mekk4_bringup/mekk4_bringup/bno085_node.py modified: src/mekk4_bringup/package.xml modified: src/mekk4_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
    [two_wheel_robot.urdf]
2026-03-19 modified: src/robot_description/urdf/two_wheel_robot.urdf
    [two_wheel_robot.urdf]
2026-03-20 modified: src/robot_bringup/package.xml modified: src/robot_description/urdf/two_wheel_robot.urdf modified: src/robot_gz/worlds/robot3.sdf
    [robot3.sdf, two_wheel_robot.urdf]
2026-03-20 modified: src/robot_bringup/launch/lidar_nav2_compat.launch.py modified: src/robot_bringup/launch/minimal_all.launch.py modified: src/robot_bringup/launch/pi_robot.launch.py modified: src/robot_descr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
    [robot3.sdf, two_wheel_robot.urdf]
2026-03-20 modified: src/robot_bringup/launch/minimal_all.launch.py modified: src/robot_bringup/launch/pi_robot.launch.py renamed: src/robot_description/urdf/two_wheel_robot.urdf -> src/robot_description/urdf/t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
    [tracked_robot.urdf, tracked_robot_world.sdf]
2026-03-20 modified: README.md modified: src/robot_bringup/launch/minimal_all.launch.py modified: src/robot_gz/worlds/tracked_robot_world.sdf new file: src/robot_minimal_control/robot_minimal_control/sim_keyboa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
    [tracked_robot_world.sdf]
2026-03-20 modified: src/robot_bringup/CMakeLists.txt modified: src/robot_bringup/launch/minimal_all.launch.py modified: src/robot_bringup/package.xml modified: src/robot_bringup/rviz/minimal_all.rviz modified: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
    [tracked_robot.urdf, tracked_robot_world.sdf]
2026-03-20 modified: README.md modified: docs/lidar_rviz.md modified: src/robot_bringup/rviz/rviz.rviz
2026-03-20 modified: src/robot_description/urdf/tracked_robot.urdf
    [tracked_robot.urdf]
2026-03-23 modified: README.md modified: config/robot_calibration.yaml
    [robot_calibration.yaml]
2026-03-23 modified: config/robot_calibration.yaml
    [robot_calibration.yaml]
2026-03-23 modified: arduino/mega_keyboard_drive/mega_keyboard_drive.ino
2026-03-23 modified: config/camera_params.yaml modified: config/nav2_params.yaml
2026-04-23 new file: AGENTS.md modified: config/ekf.yaml modified: config/nav2_params.yaml new file: frames_2026-04-23_21.14.02.gv new file: frames_2026-04-23_21.14.02.pdf modified: scripts/sim_stop.sh modified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
    [Camera.stl, Drive-L.stl, Drive-R.stl, IMU.stl, Lidar.stl, ML.stl, MR.stl, Midsection.stl]
2026-04-24 SIM med tracks og modell
    [tracked_robot.urdf, tracked_robot_world.sdf]
2026-04-24 renamed: src/robot_gz/worlds/robot_minimal_control/resource/robot_minimal_control -> .codex modified: .gitignore deleted: FusionExport3/Gazebo/Gazebo.urdf renamed: FusionExport3/Gazebo/meshes/Camera.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
    [Camera.stl, Drive-L.stl, Drive-R.stl, Gazebo.urdf, IMU.stl, Lidar.stl, ML.stl, MR.stl]
2026-04-27 små fix i params og sdf
    [tracked_robot_world.sdf]
2026-04-28 lagt til Overhead kamera.
    [model.sdf, tracked_robot_world.sdf]
2026-04-29 modified: README.md modified: docs/wiki/arduino-mega.md
2026-04-29 modified: docs/wiki/arduino-mega.md modified: scripts/mega_motor_test.py modified: scripts/mega_motor_test.sh
2026-04-29 modified: docs/wiki/arduino-mega.md modified: docs/wiki/hardware.md
2026-04-29 modified: README.md modified: arduino/mega_dfr0601_test/mega_dfr0601_test.ino modified: arduino/mega_keyboard_drive/mega_keyboard_drive.ino modified: docs/wiki/arduino-mega.md modified: docs/wiki/har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
2026-05-01 modified: Makefile new file: src/mekk4_perception/mekk4_perception/sim_camera_udp_stream.py modified: src/mekk4_perception/setup.py modified: src/robot_bringup/launch/minimal_all.launch.py modified: 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
    [model.sdf, tracked_robot_world.sdf]
2026-05-01 docs: document Buildx; chore: make buildx default and add aliases; Dockerfile BuildKit cache mounts
2026-05-02 modified: config/robot_calibration.yaml modified: scripts/pi_bringup.sh modified: scripts/robot_calibration_env.py modified: src/robot_bringup/launch/pi_robot.launch.py
    [robot_calibration.yaml]
2026-05-03 modified: config/camera_params.yaml modified: docs/wiki/vision.md modified: scripts/camera_config_env.py modified: scripts/pi_bringup.sh modified: src/mekk4_perception/mekk4_perception/teddy_detector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
2026-05-03 modified: Makefile modified: README.md modified: config/camera_params.yaml modified: docs/wiki/hardware.md modified: docs/wiki/lidar-rviz.md modified: docs/wiki/pc-tools.md modified: docs/wiki/physic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
2026-05-03 modified: config/camera_params.yaml modified: config/nav2_params.yaml modified: scripts/pi_bringup.sh modified: src/mekk4_bringup/mekk4_bringup/cmd_vel_mux_node.py modified: src/mekk4_bringup/mekk4_b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
2026-05-06 modified: config/robot_calibration.yaml modified: config/teddy_approach.yaml
    [robot_calibration.yaml]
2026-05-06 modified: "arduino/mega_distansem\303\245ler/distansekode" modified: arduino/mega_keyboard_drive/mega_keyboard_drive.ino new file: arduino/mega_stepper_x/Xstep new file: arduino/mega_stepper_z/Zstep 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
2026-05-08 new file: arduino/limit_switch_test/limit_switch_test.ino renamed: arduino/mega_keyboard_drive/mega_keyboard_drive.ino -> arduino/mega_total_code/mega_total_code.ino modified: src/mekk4_bringup/mekk4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
2026-05-08 new file: arduino/mega_total_code_nonblocking/mega_total_code_nonblocking.ino
2026-05-08 modified: arduino/mega_total_code/mega_total_code.ino modified: src/mekk4_bringup/mekk4_bringup/mega_driver_node.py modified: src/mekk4_bringup/mekk4_bringup/robotarm_safety_node.py modified: src/mek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
2026-05-08 modified: arduino/mega_total_code_nonblocking/mega_total_code_nonblocking.ino
2026-05-08 modified: arduino/mega_total_code/mega_total_code.ino
2026-05-08 modified: Makefile modified: arduino/mega_total_code_nonblocking/mega_total_code_nonblocking.ino modified: scripts/mega_serial_terminal.py modified: src/mekk4_bringup/mekk4_bringup/mega_driver_node.p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
2026-05-08 modified: arduino/mega_total_code/mega_total_code.ino modified: arduino/mega_total_code_nonblocking/mega_total_code_nonblocking.ino modified: src/mekk4_bringup/mekk4_bringup/mega_driver_node.py modif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
2026-05-08 modified: docs/wiki/calibration.md modified: scripts/mega_calibration.py
2026-05-08 modified: config/robot_calibration.yaml modified: docs/wiki/calibration.md modified: scripts/mega_calibration.py
    [robot_calibration.yaml]
2026-05-08 modified: config/robot_calibration.yaml modified: scripts/pi_bringup.sh modified: scripts/robot_calibration_env.py modified: src/mekk4_bringup/mekk4_bringup/mega_driver_node.py modified: src/robot_br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
    [robot_calibration.yaml]
2026-05-08 new file: config/robotarm_params.yaml new file: config/teddy_grab.yaml modified: docs/wiki/arduino-mega.md modified: docs/wiki/calibration.md modified: docs/wiki/ros-interfaces.md modified: scripts/p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
    [robotarm_params.yaml]
2026-05-09 new file: arduino/mega_distance_test/mega_distance_test.ino modified: "arduino/mega_distansem\303\245ler/distansekode" modified: arduino/mega_total_code_nonblocking/mega_total_code_nonblocking.ino mo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
    [robotarm_params.yaml]
2026-05-09 robot_description: new Fusion export (URDF, SDF, meshes)
    [ABX00102-Dist-sensor.stl, BLLegs.stl, BN0085.stl, BRLegs.stl, Bottom-Rack-200.0mm-L30.00-m2.1651.stl, Chassis.stl, FLLegs.stl, FRLegs.stl]
2026-05-09 sim: add robotarm_sim_params, update launch and rviz config
    [robotarm_sim_params.yaml]
2026-05-09 robot: port to new Fusion export (Tank3), fix sideways driving
    - New model.sdf built from Fusion Gazebo.sdf with:
    - base_link root (yaw=+pi/2 in model frame) for correct ROS forward axis
    - TrackedVehicle drive proxy boxes on LTracks/RTracks (fdir1=0 1 0)
    - Spring/damping on 4 suspension joints (Chassis_Revolute-1/2/7/8)
    - Camera, IMU, LiDAR sensors on Chassis link
    - All plugins: TrackedVehicle, TrackController x2, JointPositionController x4,
    JointStatePublisher, PosePublisher
    - World spawn yaw set to -pi/2 to cancel base_link rotation:
    base_link world yaw=0, forward=base_link X=track fdir1 direction
    - Mesh update: removed 21 obsolete STL files, updated all 45 new STL files
    -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
    [Camera.stl, Drive-L.stl, Drive-R.stl, IMU.stl, LeadNut.stl, Lidar.stl, ML.stl, MR.stl]
2026-05-09 modified: src/robot_bringup/launch/minimal_all.launch.py modified: src/robot_gz/models/tracked_robot/model.sdf modified: src/robot_gz/worlds/tracked_robot_world.sdf
    [model.sdf, tracked_robot_world.sdf]
2026-05-09 modified: config/robotarm_params.yaml modified: config/robotarm_sim_params.yaml modified: scripts/sim_stop.sh modified: src/mekk4_bringup/mekk4_bringup/ros_keyboard_teleop.py modified: src/robot_brin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
    [model.sdf, robotarm_params.yaml, robotarm_sim_params.yaml]
2026-05-10 modified: config/robotarm_sim_params.yaml modified: src/mekk4_bringup/mekk4_bringup/robotarm_safety_node.py modified: src/mekk4_bringup/mekk4_bringup/ros_keyboard_teleop.py modified: src/robot_bringu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
    [model.sdf, robotarm_sim_params.yaml, tracked_robot.urdf]
2026-05-10 modified: arduino/mega_total_code_nonblocking/mega_total_code_nonblocking.ino modified: config/robotarm_params.yaml modified: config/robotarm_sim_params.yaml modified: config/teddy_grab.yaml modified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
    [robotarm_params.yaml, robotarm_sim_params.yaml]
2026-05-10 modified: Makefile modified: config/robotarm_params.yaml deleted: config/robotarm_sim_params.yaml modified: config/teddy_approach.yaml modified: config/teddy_grab.yaml new file: src/mekk4_bringup/mek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
    [model.sdf, robotarm_params.yaml, robotarm_sim_params.yaml, tracked_robot.urdf, tracked_robot_world.sdf]
2026-05-10 modified: config/robotarm_params.yaml modified: config/teddy_grab.yaml modified: src/mekk4_bringup/mekk4_bringup/mega_driver_node.py modified: src/mekk4_bringup/mekk4_bringup/teddy_grab_node.py
    [robotarm_params.yaml]
2026-05-10 modified: config/robotarm_params.yaml modified: src/mekk4_bringup/mekk4_bringup/robotarm_safety_node.py
    [robotarm_params.yaml]
2026-05-10 modified: config/robotarm_params.yaml modified: config/teddy_grab.yaml modified: src/mekk4_bringup/mekk4_bringup/mega_driver_node.py
    [robotarm_params.yaml]
2026-05-10 modified: arduino/mega_total_code_nonblocking/mega_total_code_nonblocking.ino modified: config/robotarm_params.yaml modified: scripts/mega_arm_calibrate.py modified: src/mekk4_bringup/mekk4_bringup/m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
    [robotarm_params.yaml]
2026-05-10 modified: config/robotarm_params.yaml modified: src/mekk4_bringup/mekk4_bringup/mega_driver_node.py
    [robotarm_params.yaml]
2026-05-10 modified: scripts/pi_bringup.sh modified: src/mekk4_bringup/mekk4_bringup/zero_joint_state_publisher.py modified: src/robot_description/urdf/tracked_robot.urdf
    [tracked_robot.urdf]
2026-05-10 modified: config/robotarm_params.yaml modified: config/teddy_approach.yaml modified: src/mekk4_bringup/mekk4_bringup/mega_driver_node.py modified: src/mekk4_bringup/mekk4_bringup/teddy_grab_node.py
    [robotarm_params.yaml]
2026-05-11 modified: config/robotarm_params.yaml
    [robotarm_params.yaml]
2026-05-11 modified: arduino/mega_total_code_nonblocking/mega_total_code_nonblocking.ino modified: config/robotarm_params.yaml modified: config/teddy_approach.yaml
    [robotarm_params.yaml]
2026-05-11 modified: config/robotarm_params.yaml modified: config/teddy_approach.yaml
    [robotarm_params.yaml]
2026-05-11 modified: arduino/mega_total_code_nonblocking/mega_total_code_nonblocking.ino modified: src/mekk4_bringup/mekk4_bringup/mega_driver_node.py
2026-05-11 modified: config/ekf.yaml modified: config/robotarm_params.yaml
    [robotarm_params.yaml]
